peterweissig/eagle_dmx_opa/images/front_view.jpg

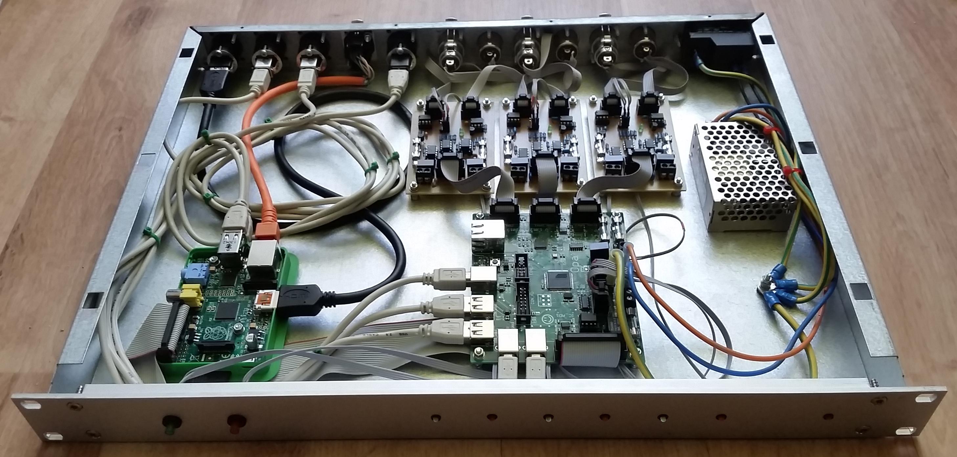
images/front_view.jpg
