peterweissig/eagle_dmx_opa/images/top_view.jpg

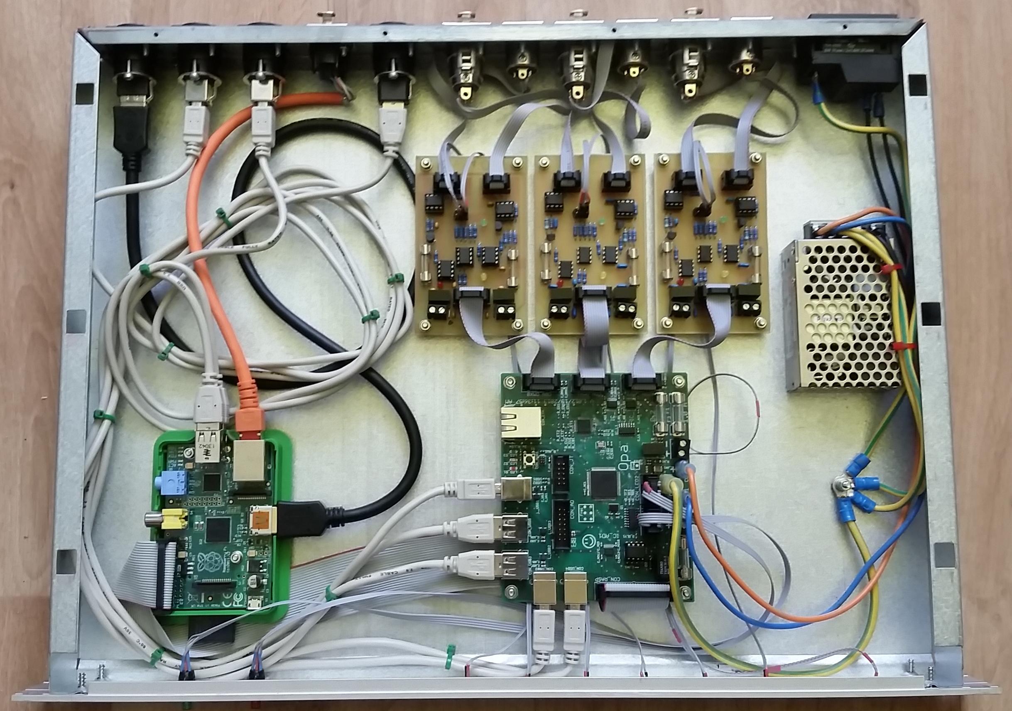
images/top_view.jpg
