peterweissig/eagle_dmx_opa/README.md

# project_opa
DMX control unit, based on atmel 32-bit controller
