peterweissig/eagle_dmx_opa/circuit/export/images/circuit_p1_controller.png

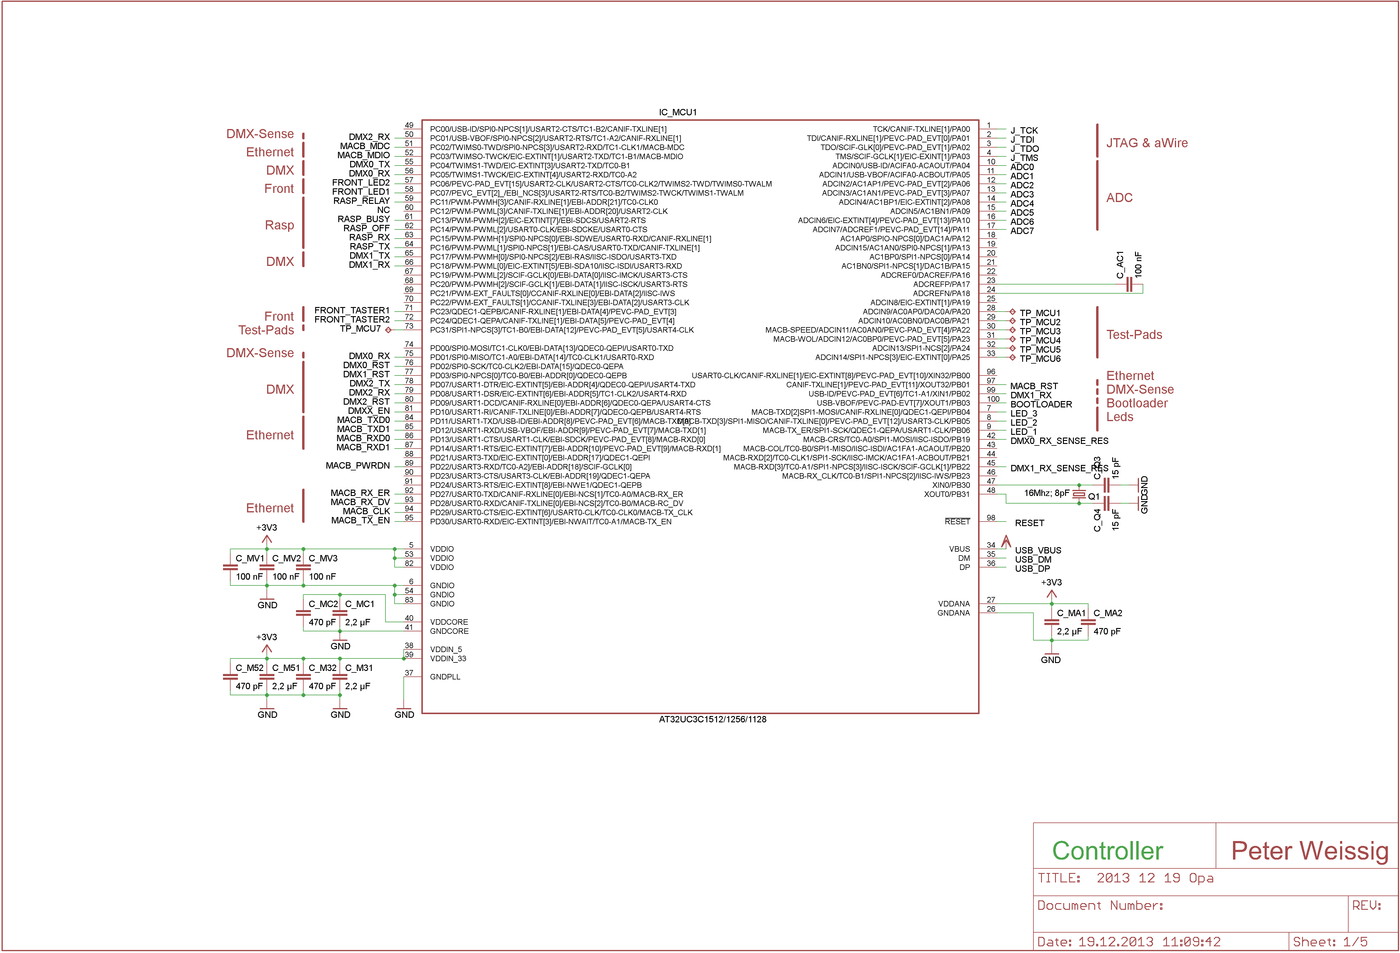
circuit/export/images/circuit_p1_controller.png
