peterweissig/eagle_dmx_opa/circuit/export/images/circuit_p2_ethernet.png

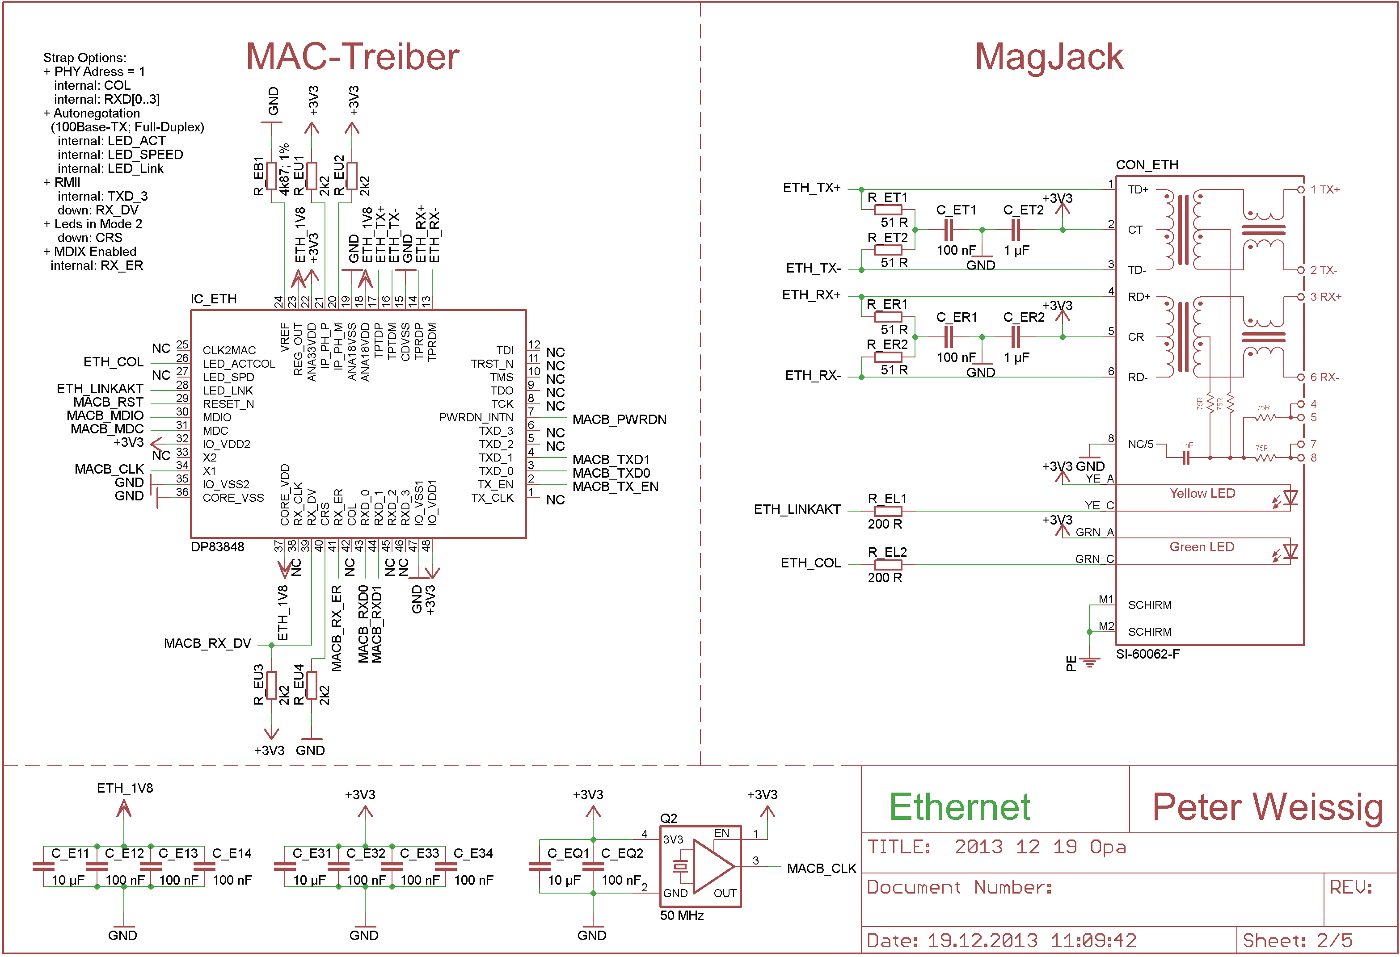
circuit/export/images/circuit_p2_ethernet.png
