peterweissig/eagle_dmx_opa/circuit/export/images/circuit_p3_schnittstellen.png

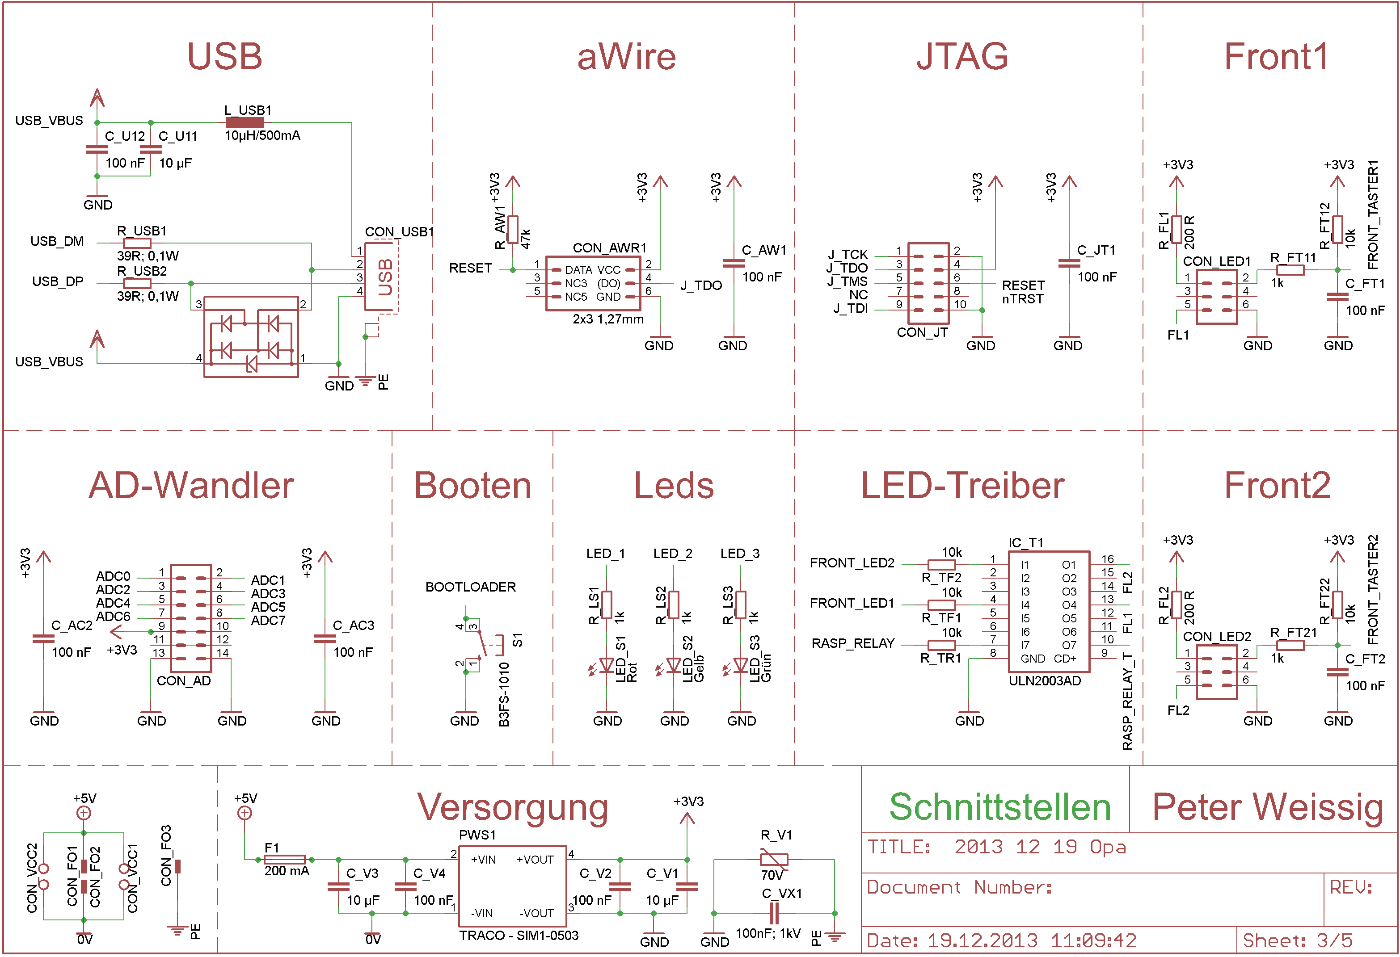
circuit/export/images/circuit_p3_schnittstellen.png
