peterweissig/eagle_dmx_opa/circuit/export/images/circuit_p4_dmx.png

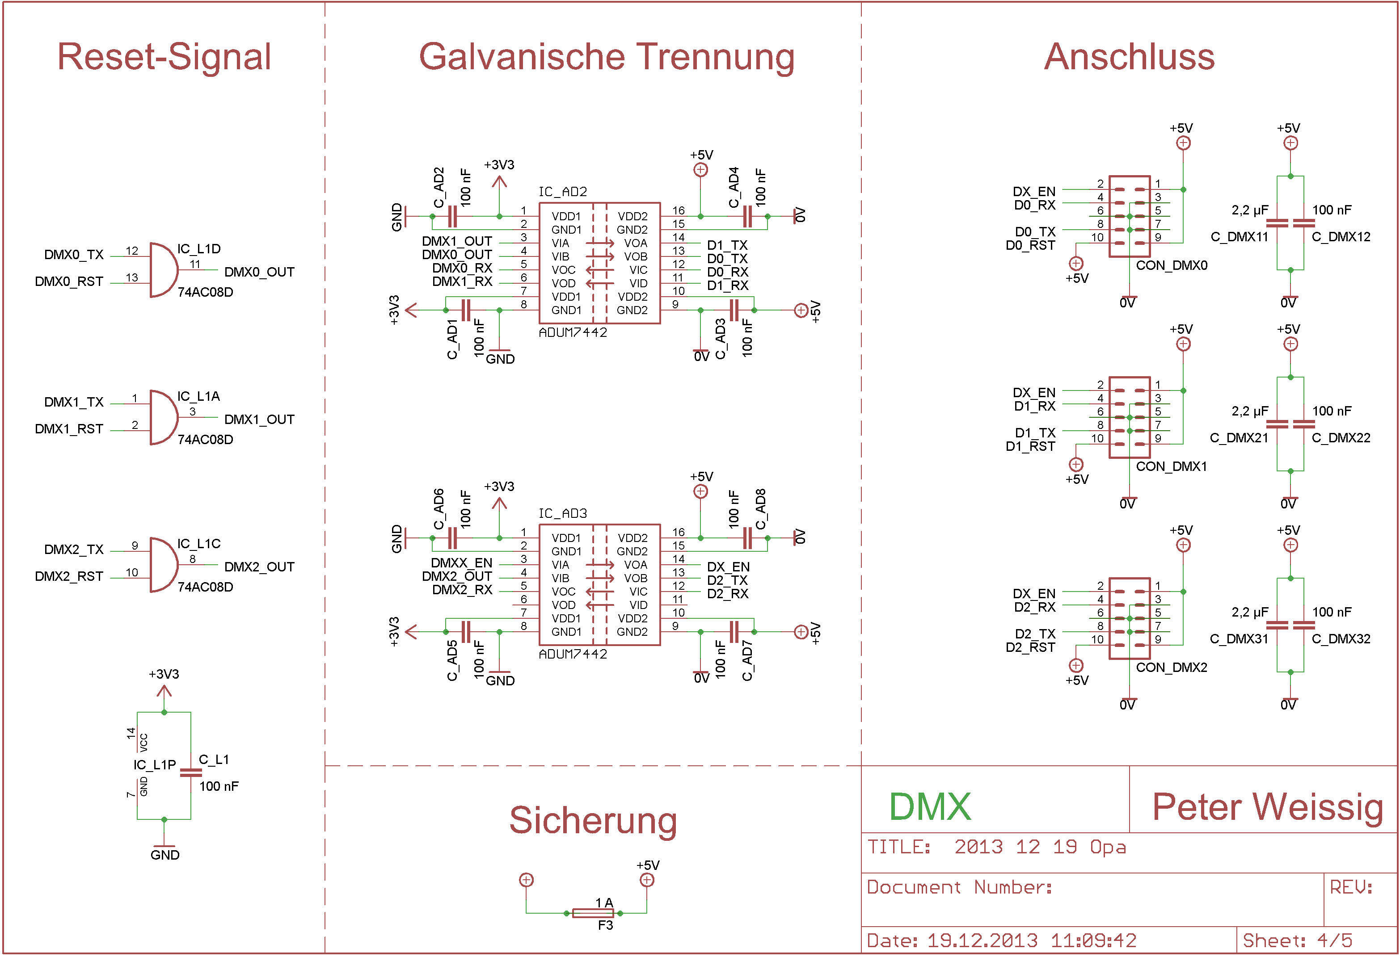
circuit/export/images/circuit_p4_dmx.png
