peterweissig/eagle_dmx_opa/circuit/export/images/circuit_p5_raspberry.png

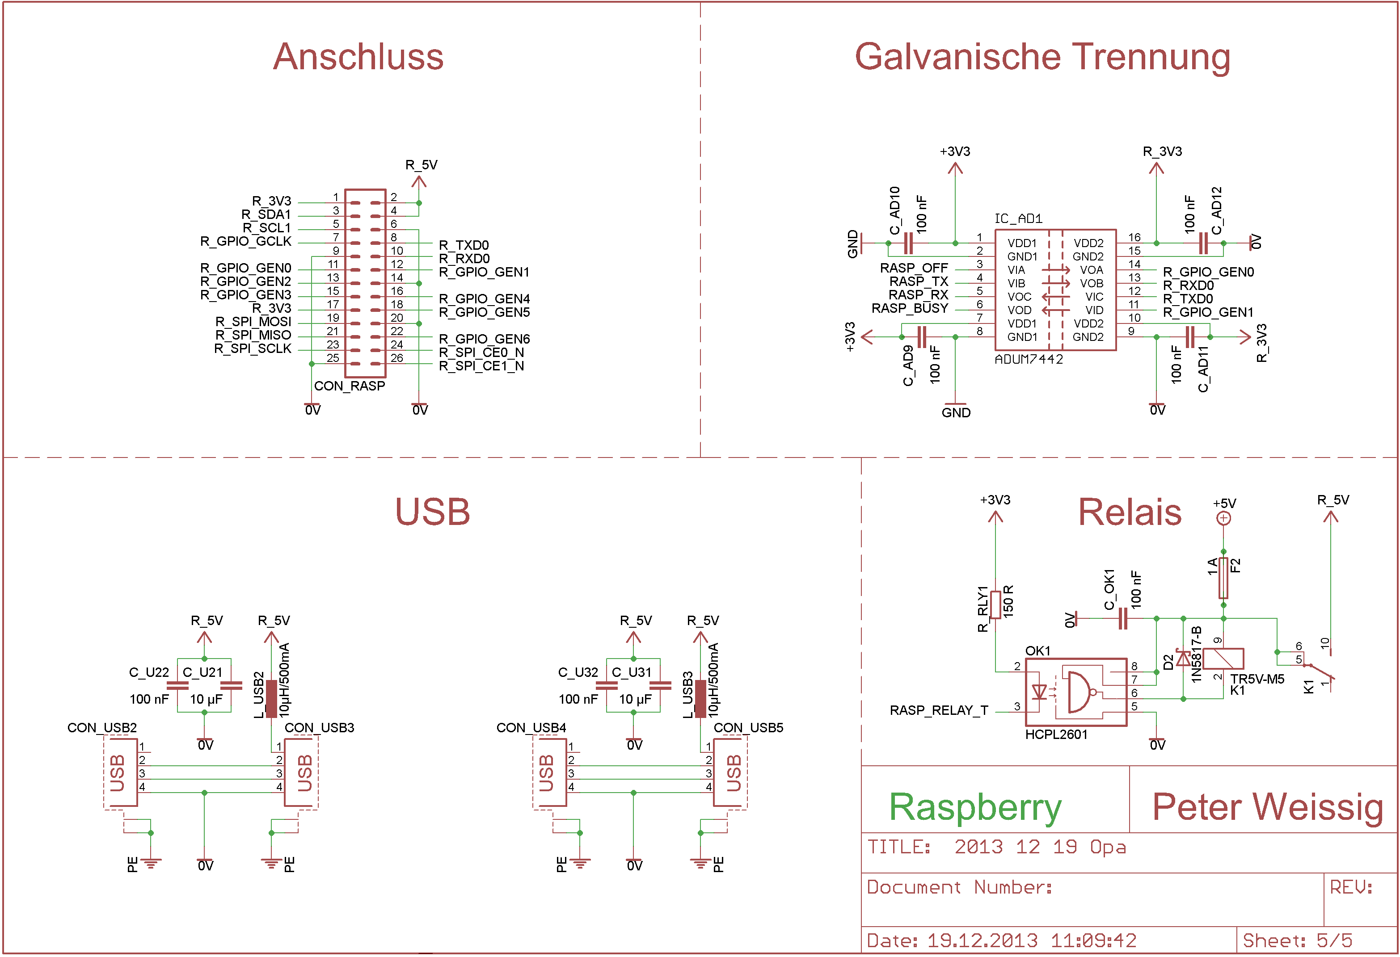
circuit/export/images/circuit_p5_raspberry.png
