peterweissig/eagle_dmx_opa/circuit/export/images/layout_bottom.png

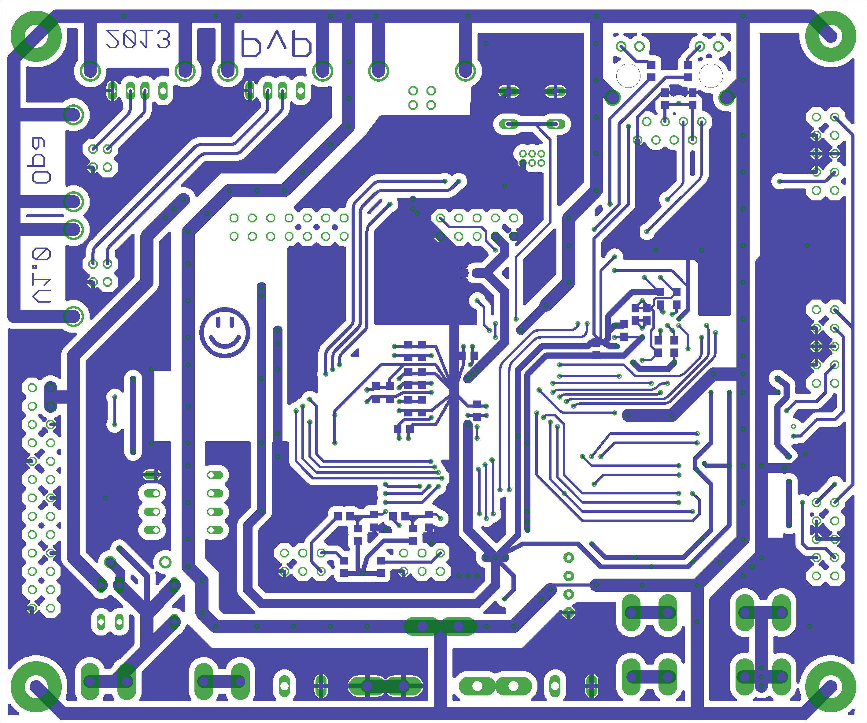
circuit/export/images/layout_bottom.png
