peterweissig/eagle_dmx_opa/circuit/export/images/layout_top.png

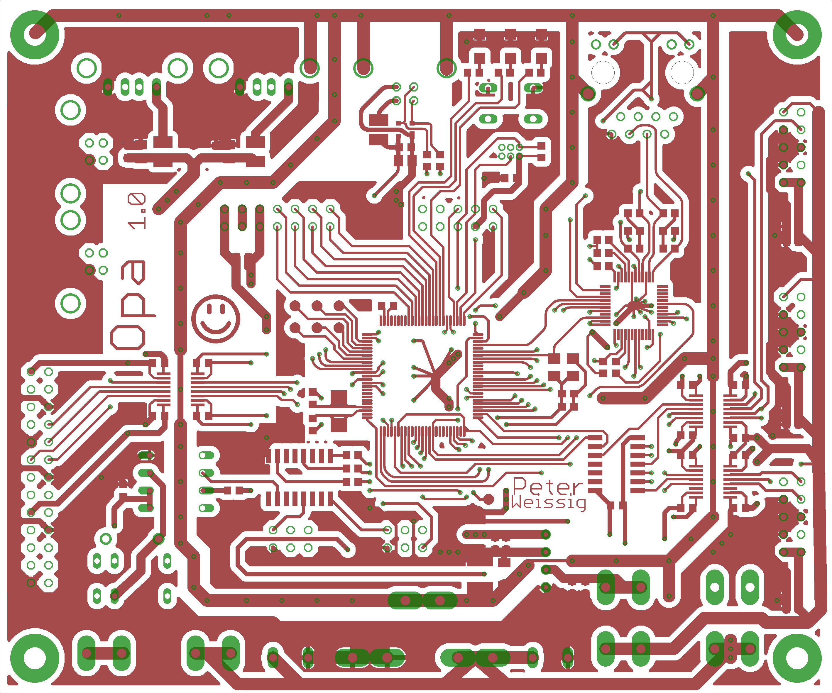
circuit/export/images/layout_top.png
