peterweissig/eagle_dmx_opa/drawings/images/front.png

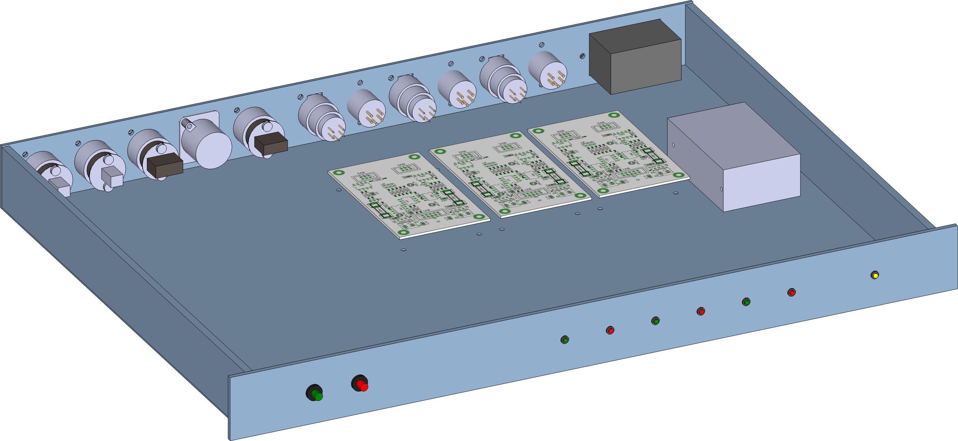
drawings/images/front.png
