peterweissig/eagle_dmx_opa/drawings/images/rear.png

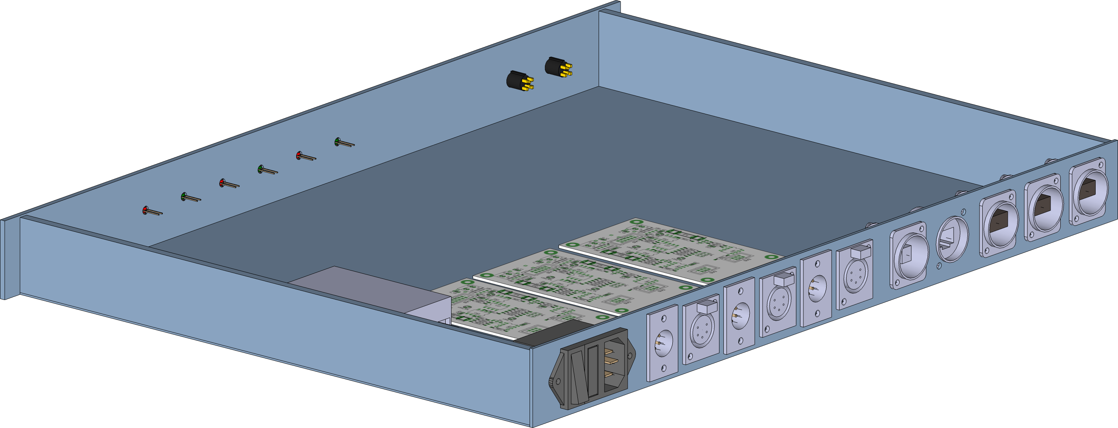
drawings/images/rear.png
