peterweissig/eagle_dmx_opa/drawings/images/top.png

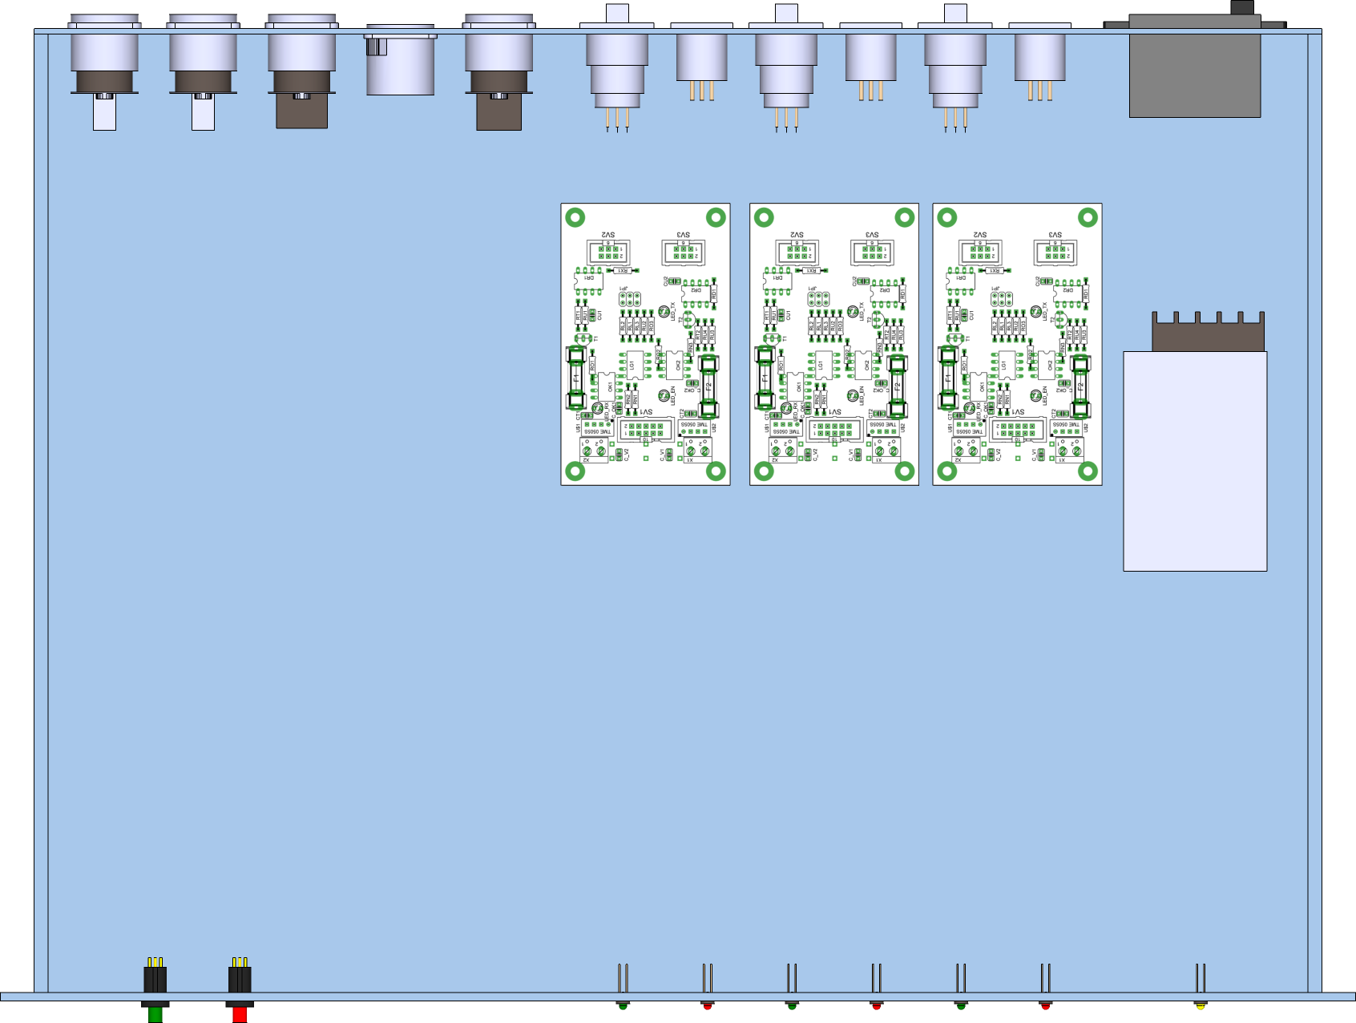
drawings/images/top.png
