peterweissig/eagle_dmx_opa/circuit/parts/parts.pdf

Bauteile Opa | 19.12.2013
Gruppe | Beschreibung | Bauteile | Anzahl | Händler | BestellNr. | Preis | Summe
| SMD SO16; NPN Transistoren im IC-Gehäuse | IC_T1 | 1 | Reichelt | ULN 2003 AD SMD (http://www.reichelt.de/index.html?ACTION=3;ARTICLE=18887;SEARCH=ULN%202003%20AD%20SMD) | 0,29 € | 0,29 €
| SMD SO14; Logik-Gatter - 4x Und; 74HC08 | IC_L1 | 1 | Reichelt | 74AC 08D-SMD (http://www.reichelt.de/index.html?ACTION=3;ARTICLE=58134;SEARCH=74AC%2008D-SMD) | 0,28 € | 0,28 €
| ADUM7442 | IC_ADx (3x) | 3 | Farnell | 1827344 (http://de.farnell.com/analog-devices/adum7442arqz/isolator-digital-quad-16qsop/dp/1827344) | 4,27 € | 12,81 €
| DP83848i | IC_ETH | 1 | Farnell | 1286816 (http://de.farnell.com/texas-instruments/dp83848cvv/10-100-ethernet-phy-smd-lqfp48/dp/1286816) | 4,11 € | 4,11 €
| AT32UC3C1512 | IC_MCU1 | 1 | Farnell | 1972032 (http://de.farnell.com/atmel/at32uc3c1512c-aut/mcu-32bit-512k-flash-100tqfp/dp/1972032?Ntt=AT32UC3C1512) | 19,67 € | 19,67 €
| SMD 0603; 10 µF; 6,3V; X5R | C_E11, C_E31, C_EQ1, C_Ux1 (3x), C_V1, C_V3 | 6 | Reichelt | X5R-G0603 10/6 (http://www.reichelt.de/Vielschicht-SMD-G0603-High-Cap/X5R-G0603-10-6/3/index.html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) | 0,07 € | 0,42 €
| SMD 0603; 2,2µF; 16V; X5R | C_Mx1 (4x), C_DMXx1 (3x) | 7 | Reichelt | X5R-G0603 2,2/16 (http://www.reichelt.de/Vielschicht-SMD-G0603-High-Cap/X5R-G0603-2-2-16/3/index.html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) | 0,05 € | 0,35 €
| SMD 0603; 1 µF; 25V; X5R | C_ER2 C_ET2 | 2 | Reichelt | X5R-G0603 1,0/25 (http://www.reichelt.de/Vielschicht-SMD-G0603-High-Cap/X5R-G0603-1-0-25/3/index.html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) | 0,05 € | 0,10 €
| SMD 1812; 100 nF; 1kV; X5R | C_VX1 | 1 | Farnell | 2085218 (http://de.farnell.com/kemet/c1812v104kdractu/kondensator-100nf-1000v-x7r-1812/dp/2085218) | 0,60 € | 0,60 €

Kondensatoren

## Teil 1 ICs

Peter Weissig | V 1.0.0 | Seite 1 von 4

Gruppe | Beschreibung | Bauteile | Anzahl | Händler | BestellNr. | Preis | Summe
| SMD 0603; 100 nF; 16V; X7R | C_ADx (12x), C_ACx (3x), C_DMXx2 (3x), X_Ex2 (3x), C_MVx (3x), C_Ux2 (3x), C_ER1, C_ET1, C_Ex3 (2x), C_Ex4 (2x), C_FTx (2x), C_V2, C_V4, C_AW1, C_JT1, C_L1, C_OK1
41 | Reichelt | X7R-G0603 100N (http://www.reichelt.de/Vielschicht-SMD-G0603/X7R-G0603-100N/3/index.html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) | 0,05 € | 2,05 €
SMD 0603; 470 pF; 50V; X7R | C_Mx2 (4x) | 4 | Reichelt | X7R-G0603 470P (http://www.reichelt.de/Vielschicht-SMD-G0603/X7R-G0603-470P/3/index.html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) | 0,05 € | 0,20 €
SMD 0603; 10 pF (15 pF); 50V; GP0 | C_Q3 C_Q4 | 2 | Reichelt | NPO-G0603 10P (http://www.reichelt.de/Vielschicht-SMD-G0603/NPO-G0603-10P/3/index.html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) | 0,05 € | 0,10 €
Varistor | SMD 1206; 30V (70V) | R_V1 | 1 | Reichelt | VC 1206-30 (http://www.reichelt.de/Heissleiter-Varistoren/VC-1206-30/3/index.html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) | 0,24 € | 0,24 € Kondensatoren Teil 2

Gruppe | Beschreibung | Bauteile | Anzahl | Händler | BestellNr. | Preis | Summe
| SMD 0603; 47k; 1% | R_AW1 | 1 | Reichelt | SMD-0603 47K (http://www.reichelt.de/SMD-0603-10-0-k-Ohm-82-0-k-Ohm/SMD-0603-47K/3/index.html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) | 0,10 € | 0,10 €
| SMD 0603; 10k; 1% | R_FTx2 (2x), R_TFx (2x), R_TR1 | 5 | Reichelt | SMD-0603 10K (http://www.reichelt.de/SMD-0603-10-0-k-Ohm-82-0-k-Ohm/SMD-0603-10K/3/index.html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) | 0,10 € | 0,50 €
| SMD 0603; 4k7 (4k87); 1% | R_EB1 | 1 | Reichelt | SMD-0603 4,7K (http://www.reichelt.de/SMD-0603-1-00-k-Ohm-8-20-k-Ohm/SMD-0603-4-7K/3/index.html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) | 0,10 € | 0,10 €
| SMD 0603; 2k2; 1% | R_Eux (4x) | 4 | Reichelt | SMD-0603 2,2K (http://www.reichelt.de/SMD-0603-1-00-k-Ohm-8-20-k-Ohm/SMD-0603-2-2K/3/index.html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) | 0,10 € | 0,40 €
| SMD 0603; 1k; 1% | R_LSx (3x), R_FTx1 (2x) | 5 | Reichelt | SMD-0603 1,0K (http://www.reichelt.de/SMD-0603-1-00-k-Ohm-8-20-k-Ohm/SMD-0603-1-0K/3/index.html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) | 0,10 € | 0,50 €
| SMD 0603; 220 R (200 R); 1% | R_ELx (2x) R_FLx (2x) | 4 | Reichelt | SMD-0603 220 (http://www.reichelt.de/SMD-0603-100-Ohm-820-Ohm/SMD-0603-220/3/index.html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) | 0,10 € | 0,40 €
| SMD 0603; 150 R; 1% | R_RLY1 | 1 | Reichelt | SMD-0603 150 (http://www.reichelt.de/SMD-0603-100-Ohm-820-Ohm/SMD-0603-150/3/index.html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) | 0,10 € | 0,10 €
| SMD 0603; 47 R (51 R); 1% | R_ERx (2x) R_ETx (2x) | 4 | Reichelt | SMD-0603 47 (http://www.reichelt.de/SMD-0603-1-00-Ohm-82-0-Ohm/SMD-0603-47/3/index.html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) | 0,10 € | 0,40 €
| SMD 0603; 39 R; 1% | R_USBx (2x) | 2 | Reichelt | SMD-0603 39 (http://www.reichelt.de/SMD-0603-1-00-Ohm-82-0-Ohm/SMD-0603-39/3/index.html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) | 0,10 € | 0,20 €
| SMD 1206; Grün; 2,2V; 25mA | LED_S3 | 1 | Reichelt | SMD-LED 1206 GN (http://www.reichelt.de/SMD-LED-0603-0805-1206/SMD-LED-1206-GN/3/index.html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) | 0,10 € | 0,10 €
| SMD 1206; Gelb; 2,1V; 30mA | LED_S2 | 1 | Reichelt | SMD-LED 1206 GE (http://www.reichelt.de/SMD-LED-0603-0805-1206/SMD-LED-1206-GE/3/index.html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) | 0,11 € | 0,11 €
| SMD 1206; Rot; 2,0V; 30mA | LED_S1 | 1 | Reichelt | SMD-LED 1206 RT (http://www.reichelt.de/SMD-LED-0603-0805-1206/SMD-LED-1206-RT/3/index.html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) | 0,13 € | 0,13 €
Quarz | 50 Mhz; xyz | Q2 | 1 | ? | | | 0,00 €
| SMD ; 16MHz; +/- 200ppm; 8pF | Q1 | 1 | ? | NX5032GA | | 0,00 €
Dioden | SMD SOT-143B; ESD-Schutz; 5,5V; PRTR5V0U2X | D1 | 1 | Farnell | 1524157 (http://de.farnell.com/nxp/prtr5v0u2x/diode-tvs-dual-sot-143b/dp/1524157) | 0,33 € | 0,33 €
| DO41; 1A; 30V; 1N5818 | D2 | 1 | Reichelt | 1N 5818 (http://www.reichelt.de/1N-UF-AA-Dioden/1N-5818/3/index.html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) | 0,06 € | 0,06 €
Spule | SMD 1210; 10µH; 300mA (500mA); 26MHz; 0,44 R | L_USBx (3x) | 3 | Reichelt | LQH3C 10µ (http://www.reichelt.de/Fest-Induktivitaeten-SMD/LQH3C-10-/3/index.html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) | 0,12 € | 0,36 €
Koppler | Relais; 60V; 2A; 1x; TR5V-M5 | K1 | 1 | Reichelt | TR5V-M 5V (http://www.reichelt.de/Miniaturrelais/TR5V-M-5V/3/index.html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) | 0,80 € | 0,80 €
| DIP8; Optokoppler; 1x; HCPL2601; siehe auch IC-SockelOK1 | | 1 | Reichelt | HCPL 2601 (http://www.reichelt.de/Optokoppler/HCPL-2601/3/index.html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) | 1,10 € | 1,10 €
Spg-Regler | SIL4; 5V auf 3,3V; 1W; Galv. Getrennt | PWS1 | 1 | Reichelt | SIM1-0503 SIL4 (http://www.reichelt.de/Wandler-Module-DC-DC/SIM1-0503-SIL4/3/index.html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) | 4,65 € | 4,65 €
Schalter | Kurzhubtaster; 6x6mm; h 5mm; 12V; 50mA | S1 | 1 | Reichelt | TASTER 9302 (http://www.reichelt.de/Kurzhubtaster/TASTER-9302/3/index.html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) | 0,11 € | 0,11 €
Sicher- | 5x20mm; 1,0 A; siehe auch Halterungen | F2 F3 | 2 | Reichelt | FLINK 1,0A (http://www.reichelt.de/5x20mm-Feinsicherungen/FLINK-1-0A/3/index.html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) | 0,32 € | 0,64 €
| 5x20mm; 200 mA; siehe auch Halterungen | F1 | 1 | Reichelt | FLINK 0,2A (http://www.reichelt.de/5x20mm-Feinsicherungen/FLINK-0-2A/3/index.html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) | 0,32 € | 0,32 €

# ungenWiderstände Leds

Gruppe | Beschreibung | Bauteile | Anzahl | Händler | BestellNr. | Preis | Summe
| 5mm; b 6,35mm; siehe auch Flachsteckerhülsen | CON_FOx (3x) | 3 | Reichelt | FS-P 6,35 (http://www.reichelt.de/Flachstecker/FS-P-6-35/3/index.html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) | 0,05 € | 0,15 €
| 5,08mm; 13A; 2x; d 0,9mm | CON_VCCx | 2 | Reichelt | AKL 101-02 (http://www.reichelt.de/Kurzhubtaster/TASTER-9302/3/index.html?ACTION=3;ARTICLE=36605;SEARCH=AKL%20101-02) | 0,31 € | 0,62 €
| 2x3 1,27mm | CON_AWR1 | 1 | Reichelt | SL 2X10G 1,27 (http://www.reichelt.de/Stiftleisten/SL-2X10G-1-27/3/index.html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) | 0,24 € | 0,24 €
| 2x3; 2,54mm; gerade; Wannstecker; siehe Pfostenbuchse CON_LEDx (2x) | | 2 | Reichelt | WSL 6G (http://www.reichelt.de/Stiftleisten/2/index.html?ACTION=3;ARTICLE=85732;SEARCH=WSL%206G) | 0,17 € | 0,34 €
| 2x5; 2,54mm; gerade; Wannstecker; siehe Pfostenbuchse CON_DMXx (3x) | CON_JT | 4 | Reichelt | WSL 10G (http://www.reichelt.de/Stiftleisten/2/index.html?ACTION=3;ARTICLE=22816;SEARCH=WSL%2010G) | 0,08 € | 0,32 €
| 2x7; 2,54mm; gerade; Wannstecker; siehe Pfostenbuchse CON_AD | | 1 | Reichelt | WSL 14G (http://www.reichelt.de/Stiftleisten/2/index.html?ACTION=3;ARTICLE=22819;SEARCH=WSL%2014G) | 0,11 € | 0,11 €
| 2x13; 2,54mm; gerade; Wannstecker; siehe Pfostenbuchse CON_RASP | | 1 | Reichelt | WSL 26G (http://www.reichelt.de/Stiftleisten/2/index.html?ACTION=3;ARTICLE=22828;SEARCH=WSL%2026G) | 0,15 € | 0,15 €
| USB A; Buchse; gewinkelt | CON_USB3 CON_USB5 | 2 | Reichelt | USB AW (http://www.reichelt.de/USB-FireWire-Verbinder/USB-AW/3/index.html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) | 0,22 € | 0,44 €
| USB B; Buchse; gewinkelt | CON_USB1 CON_USB2 CON_USB4 | 3 | Reichelt | USB BW (http://www.reichelt.de/USB-FireWire-Verbinder/USB-BW/3/index.html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) | 0,22 € | 0,66 €
| MagJack; 2x Led; Galv. getrennt | CON_ETH | 1 | Farnell | 1137983 (http://de.farnell.com/stewart-connector/si-60062-f/kupplung-10-100base-ethernet-led/dp/1137983?Ntt=1137983) | 4,72 € | 4,72 €
| 5x20mm; Halterungen für Sicherungen | Fx | 6 | Reichelt | PL 120000 (http://www.reichelt.de/Sicherungshalter/PL-120000/3/index.html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) | 0,07 € | 0,42 €
| DIP8; IC-Sockel | OK1 | 1 | Reichelt | GS 8 (http://www.reichelt.de/IC-Sockel/GS-8/3/index.html?ACTION=3&LA=2&ARTICLE=8230&GROUPID=3215&artnr=GS+8) | 0,04 € | 0,04 €
| 6,35mm; Blau; 0,5-1,5mm²; 15A; Isoliert; Flachsteckerhülse CON_FO1 | | 1 | Reichelt | IFSH-B-6,35 (http://www.reichelt.de/Flachstecker/IFSH-B-6-35/3/index.html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) | 0,09 € | 0,09 €
| 6,35mm; Rot; 0,5-1,5mm²; 15A; Isoliert; Flachsteckerhülse CON_FO2 | | 1 | Reichelt | IFSH-R-6,35 (http://www.reichelt.de/Flachstecker/FSH-G-6-35/3/index.html?ACTION=3;ARTICLE=8770;SEARCH=IFSH-R-6,35,) | 0,08 € | 0,08 €
| 6,35mm; Gelb; 0,5-1,5mm²; 15A; Isoliert; Flachsteckerhülse CON_FO3 | | 1 | Reichelt | IFSH-G-6,35 (http://www.reichelt.de/Flachstecker/IFSH-G-6-35/3/index.html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) | 0,11 € | 0,11 €
| 6,35mm; Blau; 0,5-1,5mm²; Alternative; Flachsteckerhülse CON_FO1 | | 1 | Reichelt | FSH-B-6,35 (http://www.reichelt.de/Flachstecker/FSH-B-6-35/3/index.html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) | 0,06 € | 0,06 €
| 6,35mm; Rot; 0,5-1,5mm²; Alternative; Flachsteckerhülse CON_FO2 | | 1 | Reichelt | FSH-R-6,35 (http://www.reichelt.de/Flachstecker/FSH-R-6-35/3/index.html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) | 0,06 € | 0,06 €
| 6,35mm; Gelb; 0,5-1,5mm²; Alternative; Flachsteckerhülse CON_FO3 | | 1 | Reichelt | FSH-G-6,35 (http://www.reichelt.de/Flachstecker/FSH-R-6-35/3/index.html?ACTION=3;ARTICLE=7910;SEARCH=FSH-G-6,35) | 0,07 € | 0,07 €
| 2x3; 2,54mm; gerade; Pfostenbuchse | CON_LEDx (2x) | 2 | Reichelt | PFL 6 (http://www.reichelt.de/Pfosten-Wannenstecker/2/index.html?ACTION=3;ARTICLE=53153;SEARCH=PFL%206) | 0,24 € | 0,48 €
| 2x5; 2,54mm; gerade; Pfostenbuchse | CON_DMXx (3x) | 6 | Reichelt | PFL 10 (http://www.reichelt.de/Pfosten-Wannenstecker/PFL-10/3/index.html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) | 0,08 € | 0,48 €
| 2x7; 2,54mm; gerade; Pfostenbuchse | CON_AD | 2 | Reichelt | PFL 14 (http://www.reichelt.de/Pfosten-Wannenstecker/PFL-14/3/index.html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) | 0,12 € | 0,24 €
| 2x13; 2,54mm; gerade; Pfostenbuchse | CON_RASP | 2 | Reichelt | PFL 26 (http://www.reichelt.de/Pfosten-Wannenstecker/PFL-26/3/index.html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) | 0,17 € | 0,34 €

### Summe

Zusatz

62,85 €

Stecker
