peterweissig/eagle_dmx_opa/circuit/export/images/parts_bottom.png

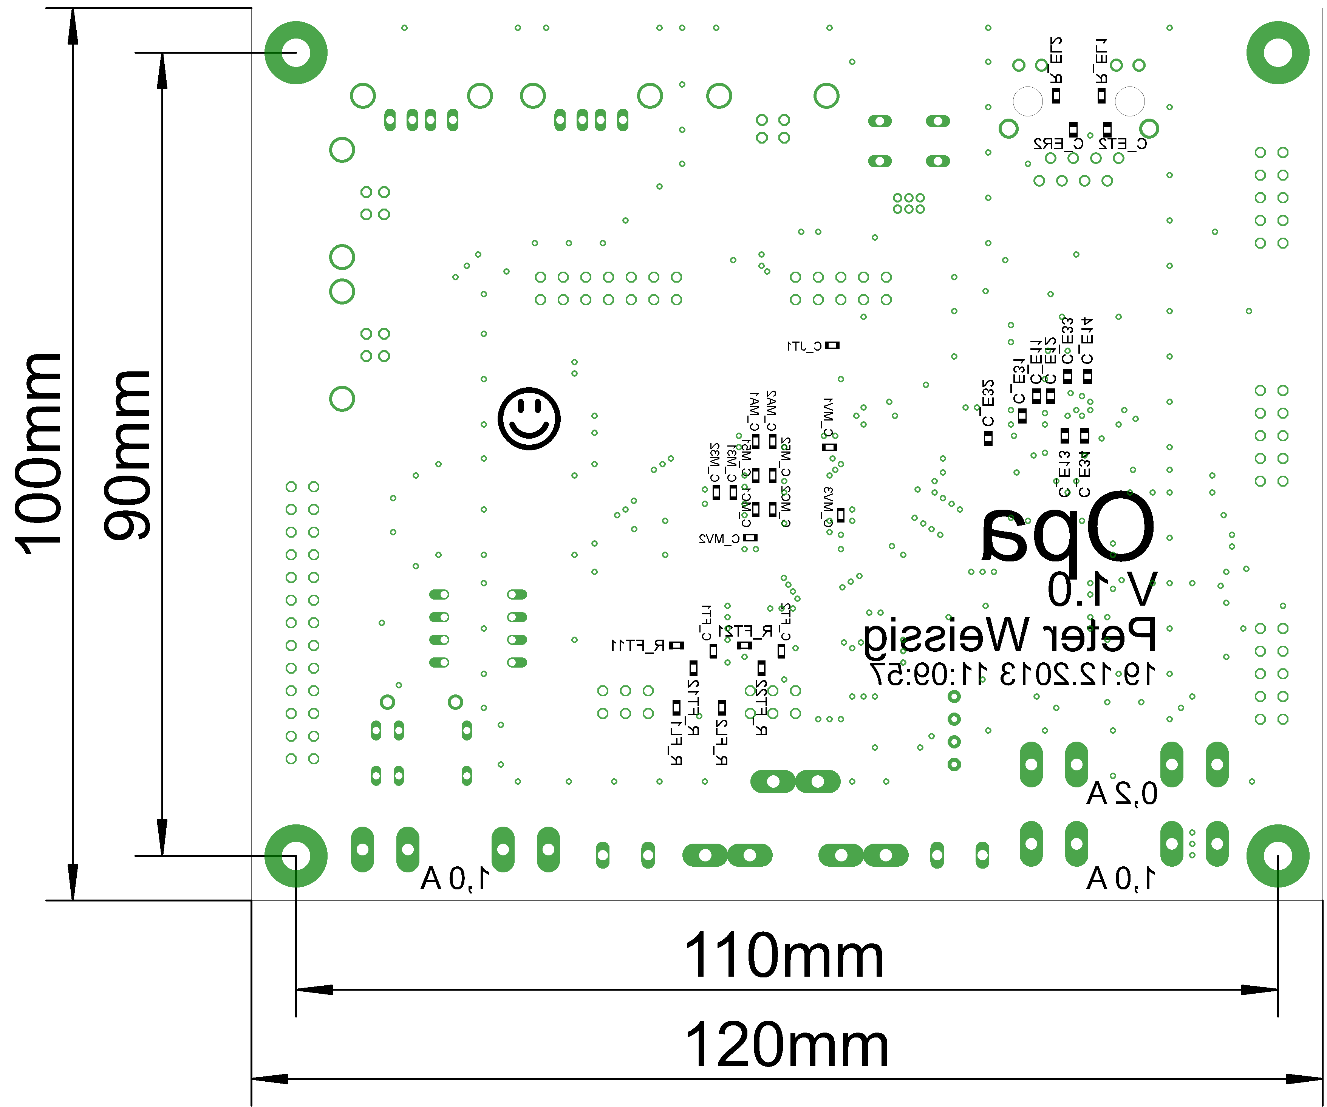
circuit/export/images/parts_bottom.png
