peterweissig/eagle_dmx_opa/circuit/export/images/parts_top.png

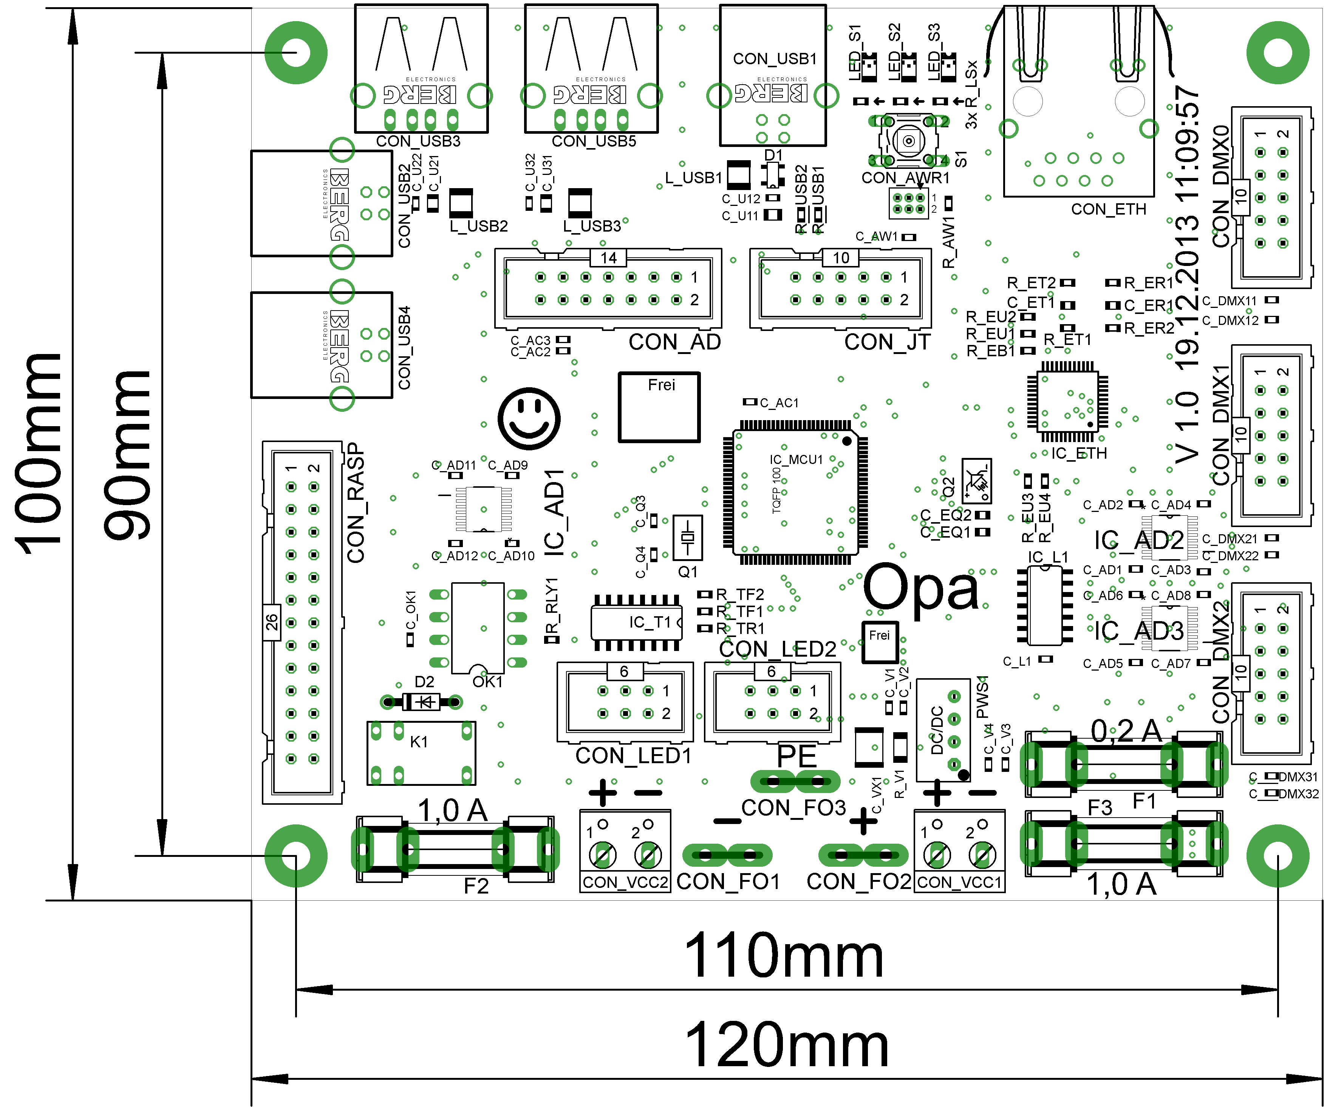
circuit/export/images/parts_top.png
