peterweissig/eagle_dmx_opa/(list of files, cad)

Other CAD files:
drawings/opa.skp
