peterweissig/eagle_dmx_opa/drawings/measures/measures_bottom.png

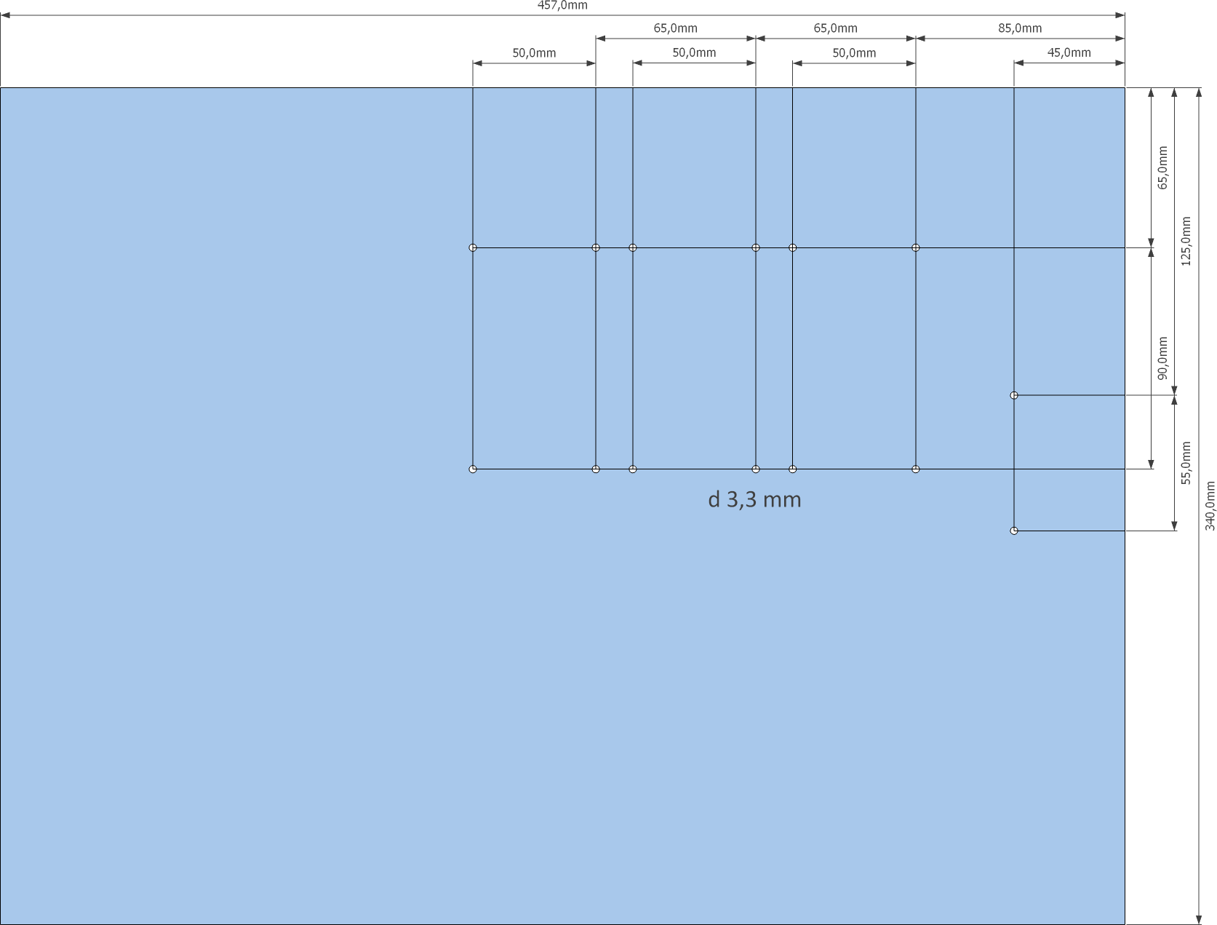
drawings/measures/measures_bottom.png
