peterweissig/eagle_dmx_opa/drawings/measures/measures_front.png

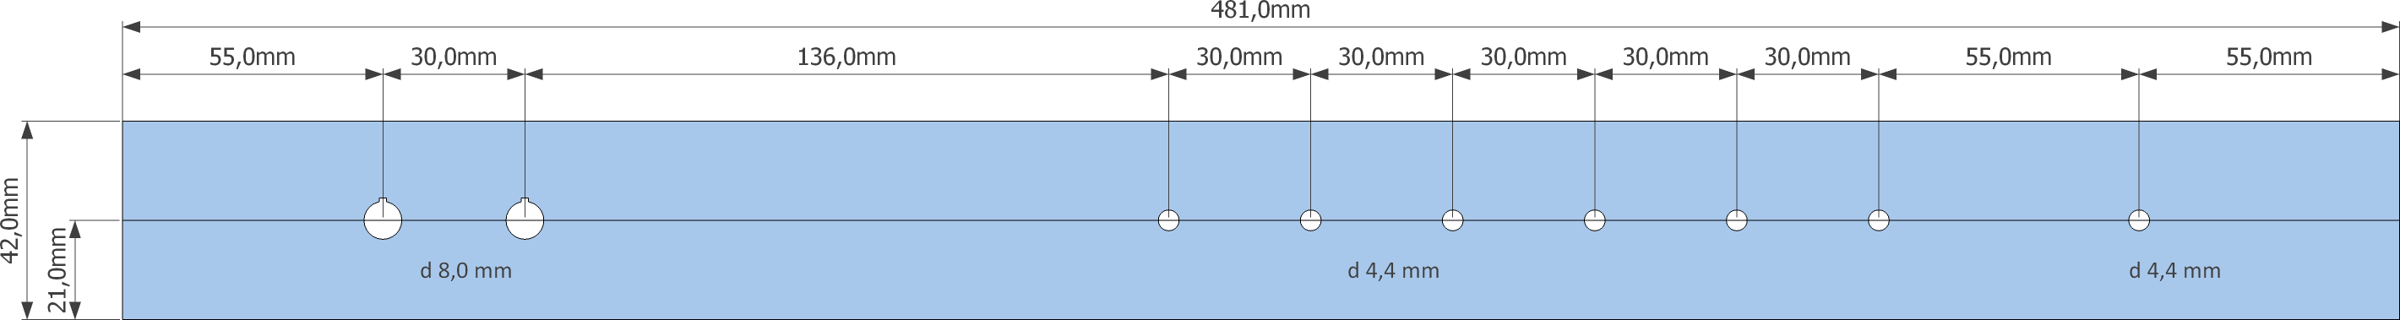
drawings/measures/measures_front.png
