peterweissig/eagle_dmx_opa/drawings/measures/measures_rear.png

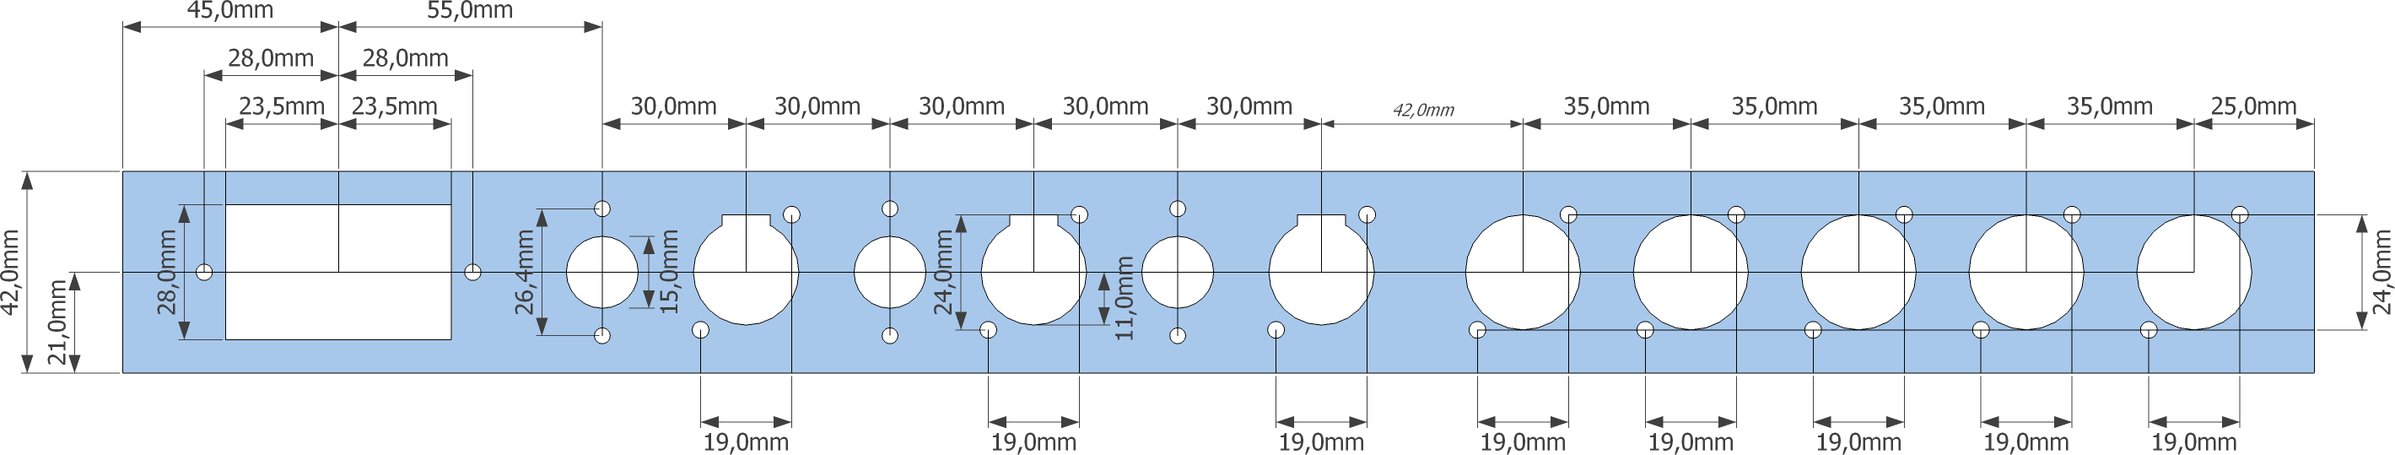
drawings/measures/measures_rear.png
