peterweissig/eagle_dmx_opa/drawings/measures/measures_rear_better.pdf

# Materialstärke 1mm; Biegung nach hinten; Innenmaß nach dem Biegen 38,1 mm

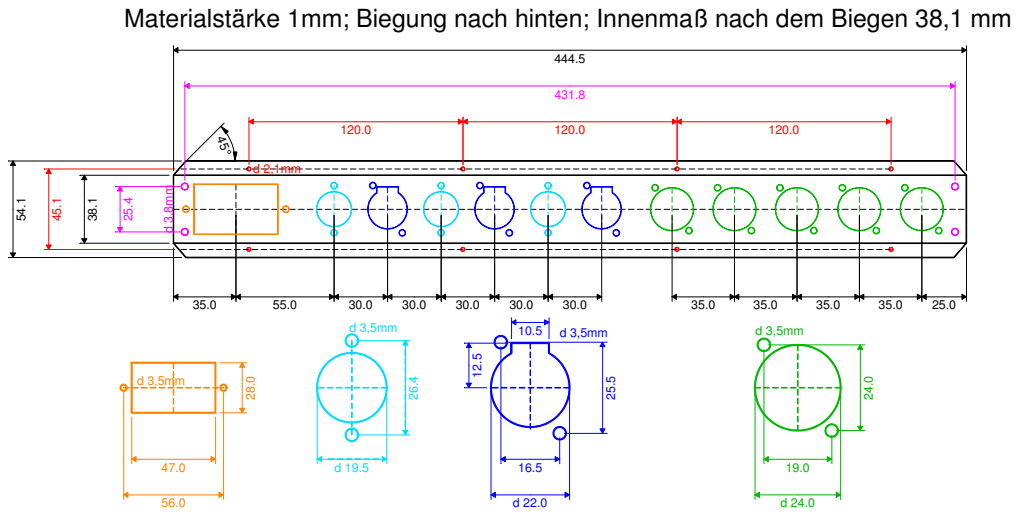
[picture p18: page 1]
