peterweissig/eagle_dmx_opa/circuit/export/images/circuit.pdf

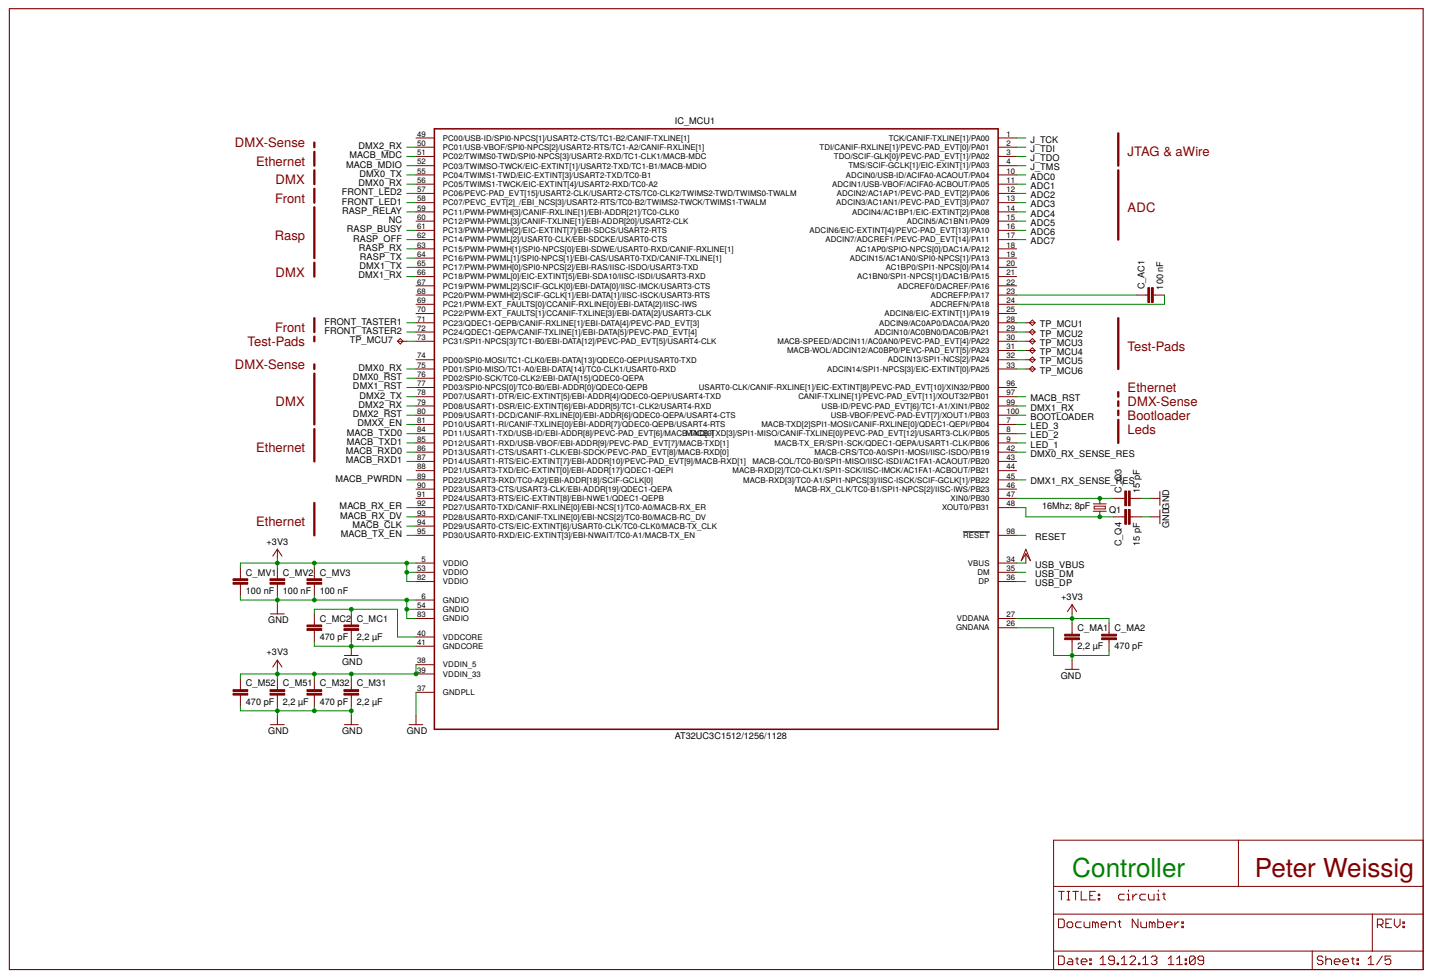
[picture p19: page 1]

1 TDI/CANIF-RXLINE[1]/PEVC-PAD_EVT[0]/PA01
2 TDO/SCIF-GLK[0]/PEVC-PAD_EVT[1]/PA02
3 TMS/SCIF-GCLK[1]/EIC-EXINT[1]/PA03
4 ADCIN0/USB-ID/ACIFA0-ACAOUT/PA04
10 ADCIN1/USB-VBOF/ACIFA0-ACBOUT/PA05
11 ADCIN2/AC1AP1/PEVC-PAD_EVT[2]/PA06
12 ADCIN3/AC1AN1/PEVC-PAD_EVT[3]/PA07
13 ADCIN4/AC1BP1/EIC-EXTINT[2]/PA08

USART0-CLK/CANIF-RXLINE[1]/EIC-EXTINT[8]/PEVC-PAD_EVT[10]/XIN32/PB00

96 CANIF-TXLINE[1]/PEVC-PAD_EVT[11]/XOUT32/PB01
99 USB-VBOF/PEVC-PAD-EVT[7]/XOUT1/PB03
USB-ID/PEVC-PAD_EVT[6]/TC1-A1/XIN1/PB02

100 MACB-TXD[2]SPI1-MOSI/CANIF-RXLINE[0]/QDEC1-QEPI/PB04
8 MACB-TX_ER/SPI1-SCK/QDEC1-QEPA/USART1-CLK/PB06

7 MACB-TXD[3]/SPI1-MISO/CANIF-TXLINE[0]/PEVC-PAD_EVT[12]/USART3-CLK/PB05

MACB-CRS/TC0-A0/SPI1-MOSI/IISC-ISDO/PB19

43 MACB-RXD[2]/TC0-CLK1/SPI1-SCK/IISC-IMCK/AC1FA1-ACBOUT/PB21
MACB-COL/TC0-B0/SPI1-MISO/IISC-ISDI/AC1FA1-ACAOUT/PB20
44 MACB-RXD[3]/TC0-A1/SPI1-NPCS[3]/IISC-ISCK/SCIF-GCLK[1]/PB22

MACB-RX_CLK/TC0-B1/SPI1-NPCS[2]/IISC-IWS/PB23
