peterweissig/eagle_dmx_opa/circuit/circuit.brd

## EAGLE design circuit/circuit.brd (2018-02-25)

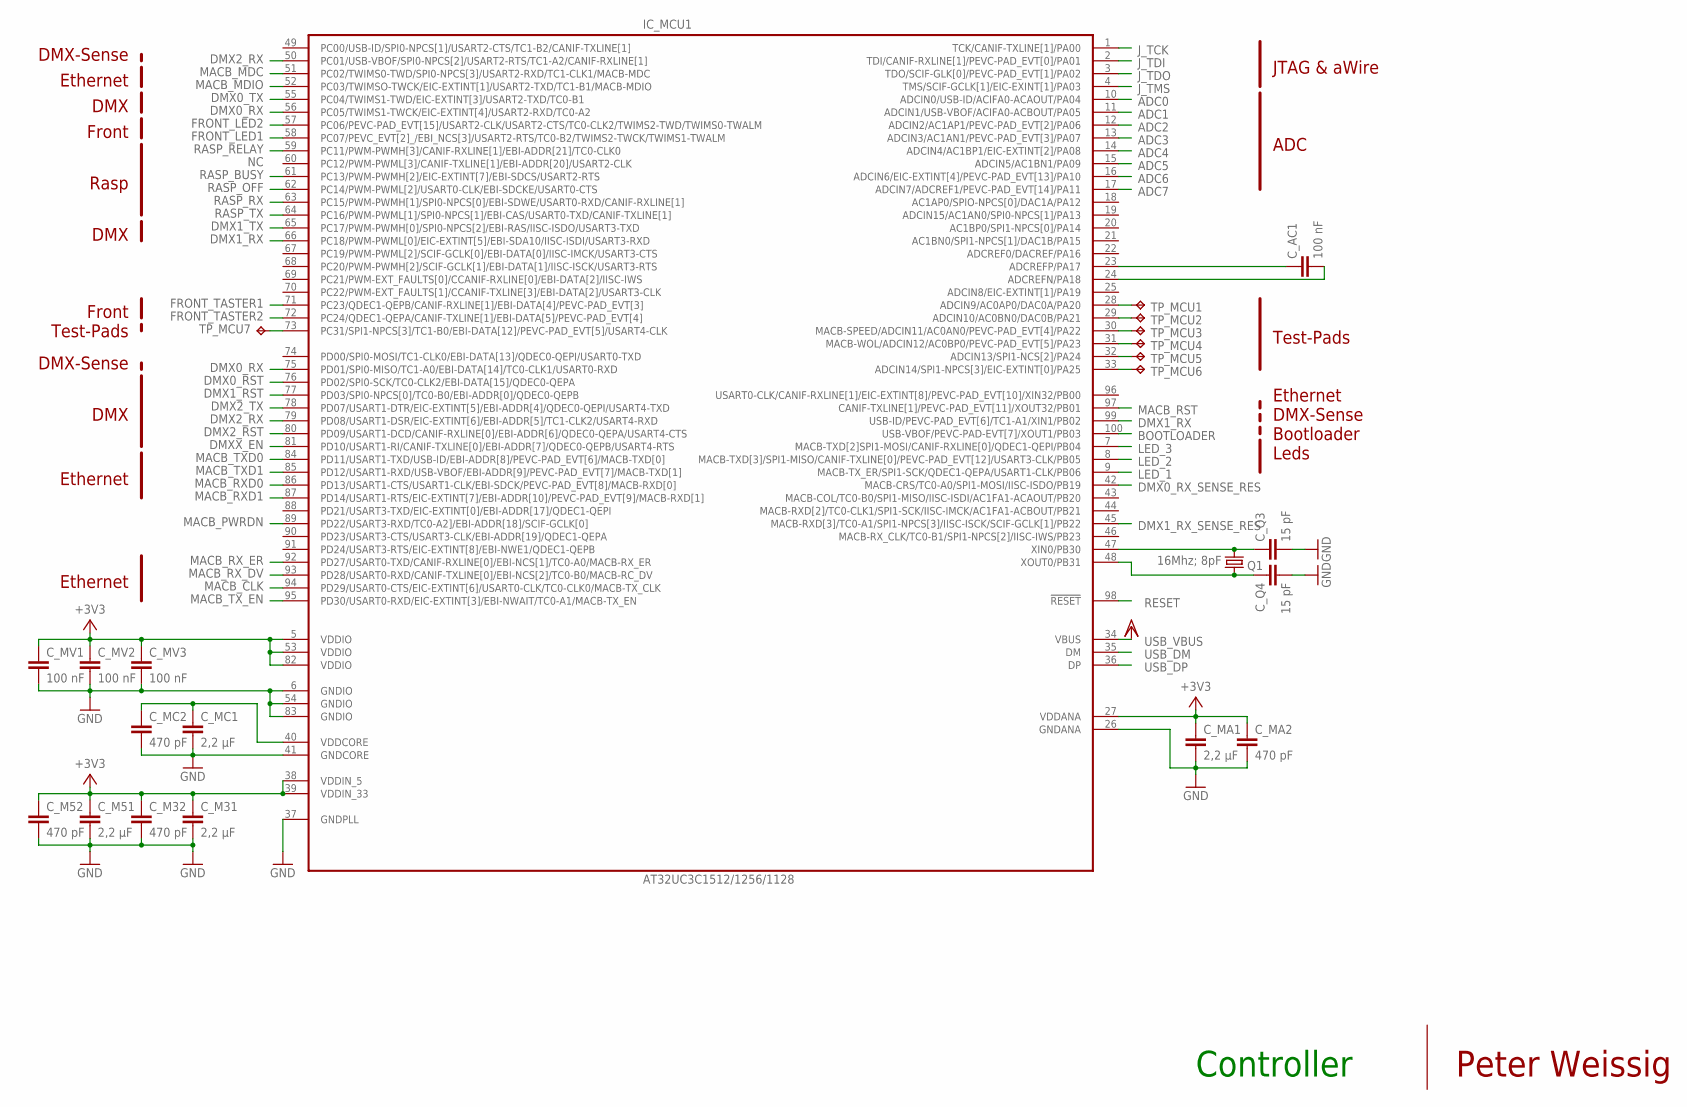
[picture p20: schematic circuit.sch, sheet 1, Controller]

Parts:
C_AC1: 100 nF; C0603K
C_M31, C_M51: 2,2 µF; C0603K
C_M32, C_M52: 470 pF; C0603K
C_MA1: 2,2 µF; C0603K
C_MA2: 470 pF; C0603K
C_MC1: 2,2 µF; C0603K
C_MC2: 470 pF; C0603K
C_MV1, C_MV2, C_MV3: 100 nF; C0603K
C_Q3, C_Q4: 15 pF; C0603K
IC_MCU1: AT32UC3C1512/1256/1128; TQFP100
Q1: 16Mhz; 8pF; NX5032
TP_MCU1, TP_MCU2, TP_MCU3, TP_MCU4, TP_MCU5, TP_MCU6, TP_MCU7: TPTP15R; TP15R

Connections:
+3V3: C_M31.1, C_M32.1, C_M51.1, C_M52.1, C_MA1.1, C_MA2.1, C_MV1.1, C_MV2.1, C_MV3.1, IC_MCU1.5 (VDDIO), IC_MCU1.27 (VDDANA), IC_MCU1.38 (VDDIN_5), IC_MCU1.39 (VDDIN_33), IC_MCU1.53 (VDDIO), IC_MCU1.82 (VDDIO); also elsewhere on the board
ADC0: IC_MCU1.10 (ADCIN0/USB-ID/ACIFA0-ACAOUT/PA04); also elsewhere on the board
ADC1: IC_MCU1.11 (ADCIN1/USB-VBOF/ACIFA0-ACBOUT/PA05); also elsewhere on the board
ADC2: IC_MCU1.12 (ADCIN2/AC1AP1/PEVC-PAD_EVT[2]/PA06); also elsewhere on the board
ADC3: IC_MCU1.13 (ADCIN3/AC1AN1/PEVC-PAD_EVT[3]/PA07); also elsewhere on the board
ADC4: IC_MCU1.14 (ADCIN4/AC1BP1/EIC-EXTINT[2]/PA08); also elsewhere on the board
ADC5: IC_MCU1.15 (ADCIN5/AC1BN1/PA09); also elsewhere on the board
ADC6: IC_MCU1.16 (ADCIN6/EIC-EXTINT[4]/PEVC-PAD_EVT[13]/P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); also elsewhere on the board
ADC7: IC_MCU1.17 (ADCIN7/ADCREF1/PEVC-PAD_EVT[14]/PA11); also elsewhere on the board
BOOTLOADER: IC_MCU1.100 (USB-VBOF/PEVC-PAD-EVT[7]/XOUT1/PB03); also elsewhere on the board
DMX0_RST: IC_MCU1.76 (PD02/SPI0-SCK/TC0-CLK2/EBI-DATA[15]/QDE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); also elsewhere on the board
DMX0_RX: IC_MCU1.56 (PC05/TWIMS1-TWCK/EIC-EXTINT[4]/USART2-R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), IC_MCU1.75 (PD01/SPI0-MISO/TC1-A0/EBI-DATA[14]/TC0-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); also elsewhere on the board
DMX0_RX_SENSE_RES: IC_MCU1.42 (MACB-CRS/TC0-A0/SPI1-MOSI/IISC-ISDO/PB19)
DMX0_TX: IC_MCU1.55 (PC04/TWIMS1-TWD/EIC-EXTINT[3]/USART2-TX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); also elsewhere on the board
DMX1_RST: IC_MCU1.77 (PD03/SPI0-NPCS[0]/TC0-B0/EBI-ADDR[0]/QD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); also elsewhere on the board
DMX1_RX: IC_MCU1.66 (PC18/PWM-PWML[0]/EIC-EXTINT[5]/EBI-SDA1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), IC_MCU1.99 (USB-ID/PEVC-PAD_EVT[6]/TC1-A1/XIN1/PB02); also elsewhere on the board
DMX1_RX_SENSE_RES: IC_MCU1.45 (MACB-RXD[3]/TC0-A1/SPI1-NPCS[3]/IISC-IS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)
DMX1_TX: IC_MCU1.65 (PC17/PWM-PWMH[0]/SPI0-NPCS[2]/EBI-RAS/I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); also elsewhere on the board
DMX2_RST: IC_MCU1.80 (PD09/USART1-DCD/CANIF-RXLINE[0]/EBI-ADD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); also elsewhere on the board
DMX2_RX: IC_MCU1.50 (PC01/USB-VBOF/SPI0-NPCS[2]/USART2-RTS/T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), IC_MCU1.79 (PD08/USART1-DSR/EIC-EXTINT[6]/EBI-ADDR[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); also elsewhere on the board
DMX2_TX: IC_MCU1.78 (PD07/USART1-DTR/EIC-EXTINT[5]/EBI-ADDR[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); also elsewhere on the board
DMXX_EN: IC_MCU1.81 (PD10/USART1-RI/CANIF-TXLINE[0]/EBI-ADDR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); also elsewhere on the board
FRONT_LED1: IC_MCU1.58 (PC07/PEVC_EVT[2]_/EBI_NCS[3]/USART2-RTS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); also elsewhere on the board
FRONT_LED2: IC_MCU1.57 (PC06/PEVC-PAD_EVT[15]/USART2-CLK/USART2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); also elsewhere on the board
FRONT_TASTER1: IC_MCU1.71 (PC23/QDEC1-QEPB/CANIF-RXLINE[1]/EBI-DAT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); also elsewhere on the board
FRONT_TASTER2: IC_MCU1.72 (PC24/QDEC1-QEPA/CANIF-TXLINE[1]/EBI-DAT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); also elsewhere on the board
FRONT_TASTER3: IC_MCU1.73 (PC31/SPI1-NPCS[3]/TC1-B0/EBI-DATA[12]/P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), TP_MCU7.TP
GND: C_M31.2, C_M32.2, C_M51.2, C_M52.2, C_MA1.2, C_MA2.2, C_MC1.2, C_MC2.2, C_MV1.2, C_MV2.2, C_MV3.2, C_Q3.2, C_Q4.2, IC_MCU1.6 (GNDIO), IC_MCU1.26 (GNDANA), IC_MCU1.37 (GNDPLL), IC_MCU1.41 (GNDCORE), IC_MCU1.54 (GNDIO), IC_MCU1.83 (GNDIO); also elsewhere on the board
J_TCK: IC_MCU1.1 (TCK/CANIF-TXLINE[1]/PA00); also elsewhere on the board
J_TDI: IC_MCU1.2 (TDI/CANIF-RXLINE[1]/PEVC-PAD_EVT[0]/PA01); also elsewhere on the board
J_TDO: IC_MCU1.3 (TDO/SCIF-GLK[0]/PEVC-PAD_EVT[1]/PA02); also elsewhere on the board
J_TMS: IC_MCU1.4 (TMS/SCIF-GCLK[1]/EIC-EXINT[1]/PA03); also elsewhere on the board
LED_1: IC_MCU1.9 (MACB-TX_ER/SPI1-SCK/QDEC1-QEPA/USART1-C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); also elsewhere on the board
LED_2: IC_MCU1.8 (MACB-TXD[3]/SPI1-MISO/CANIF-TXLINE[0]/P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); also elsewhere on the board
LED_3: IC_MCU1.7 (MACB-TXD[2]SPI1-MOSI/CANIF-RXLINE[0]/QD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); also elsewhere on the board
MACB_CLK: IC_MCU1.94 (PD29/USART0-CTS/EIC-EXTINT[6]/USART0-CL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); also elsewhere on the board
MACB_MDC: IC_MCU1.51 (PC02/TWIMS0-TWD/SPI0-NPCS[3]/USART2-RXD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); also elsewhere on the board
MACB_MDIO: IC_MCU1.52 (PC03/TWIMSO-TWCK/EIC-EXTINT[1]/USART2-T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); also elsewhere on the board
MACB_PWRDN: IC_MCU1.89 (PD22/USART3-RXD/TC0-A2]/EBI-ADDR[18]/SC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); also elsewhere on the board
MACB_RST: IC_MCU1.97 (CANIF-TXLINE[1]/PEVC-PAD_EVT[11]/XOUT32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); also elsewhere on the board
MACB_RXD0: IC_MCU1.86 (PD13/USART1-CTS/USART1-CLK/EBI-SDCK/PEV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); also elsewhere on the board
MACB_RXD1: IC_MCU1.87 (PD14/USART1-RTS/EIC-EXTINT[7]/EBI-ADDR[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); also elsewhere on the board
MACB_RX_DV: IC_MCU1.93 (PD28/USART0-RXD/CANIF-TXLINE[0]/EBI-NCS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); also elsewhere on the board
MACB_RX_ER: IC_MCU1.92 (PD27/USART0-TXD/CANIF-RXLINE[0]/EBI-NCS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); also elsewhere on the board
MACB_TXD0: IC_MCU1.84 (PD11/USART1-TXD/USB-ID/EBI-ADDR[8]/PEVC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); also elsewhere on the board
MACB_TXD1: IC_MCU1.85 (PD12/USART1-RXD/USB-VBOF/EBI-ADDR[9]/PE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); also elsewhere on the board
MACB_TX_EN: IC_MCU1.95 (PD30/USART0-RXD/EIC-EXTINT[3]/EBI-NWAIT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); also elsewhere on the board
unnamed: C_MC1.1, C_MC2.1, IC_MCU1.40 (VDDCORE)
unnamed: C_Q3.1, IC_MCU1.47 (XIN0/PB30), Q1.2
unnamed: IC_MCU1.28 (ADCIN9/AC0AP0/DAC0A/PA20), TP_MCU1.TP
unnamed: C_Q4.1, IC_MCU1.48 (XOUT0/PB31), Q1.1
unnamed: IC_MCU1.29 (ADCIN10/AC0BN0/DAC0B/PA21), TP_MCU2.TP
unnamed: IC_MCU1.30 (MACB-SPEED/ADCIN11/AC0AN0/PEVC-PAD_EVT[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), TP_MCU3.TP
unnamed: C_AC1.1, IC_MCU1.23 (ADCREFP/PA17)
unnamed: C_AC1.2, IC_MCU1.24 (ADCREFN/PA18)
unnamed: IC_MCU1.31 (MACB-WOL/ADCIN12/AC0BP0/PEVC-PAD_EVT[5]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), TP_MCU4.TP
unnamed: IC_MCU1.32 (ADCIN13/SPI1-NCS[2]/PA24), TP_MCU5.TP
unnamed: IC_MCU1.33 (ADCIN14/SPI1-NPCS[3]/EIC-EXTINT[0]/PA25), TP_MCU6.TP
RASP_BUSY: IC_MCU1.61 (PC13/PWM-PWMH[2]/EIC-EXTINT[7]/EBI-SDCS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); also elsewhere on the board
RASP_OFF: IC_MCU1.62 (PC14/PWM-PWML[2]/USART0-CLK/EBI-SDCKE/U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); also elsewhere on the board
RASP_RELAY: IC_MCU1.59 (PC11/PWM-PWMH[3]/CANIF-RXLINE[1]/EBI-AD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); also elsewhere on the board
RASP_RX: IC_MCU1.63 (PC15/PWM-PWMH[1]/SPI0-NPCS[0]/EBI-SDWE/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); also elsewhere on the board
RASP_TX: IC_MCU1.64 (PC16/PWM-PWML[1]/SPI0-NPCS[1]/EBI-CAS/U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); also elsewhere on the board
RESET: IC_MCU1.98 (!RESET); also elsewhere on the board
USB_DM: IC_MCU1.35 (DM); also elsewhere on the board
USB_DP: IC_MCU1.36 (DP); also elsewhere on the board
USB_VBUS: IC_MCU1.34 (VBUS); also elsewhere on the board

Notes on the sheet:
Controller
Peter Weissig
JTAG & aWire
ADC
Ethernet
DMX
Rasp
DMX-Sense
Leds
Bootloader
Test-Pads
Front

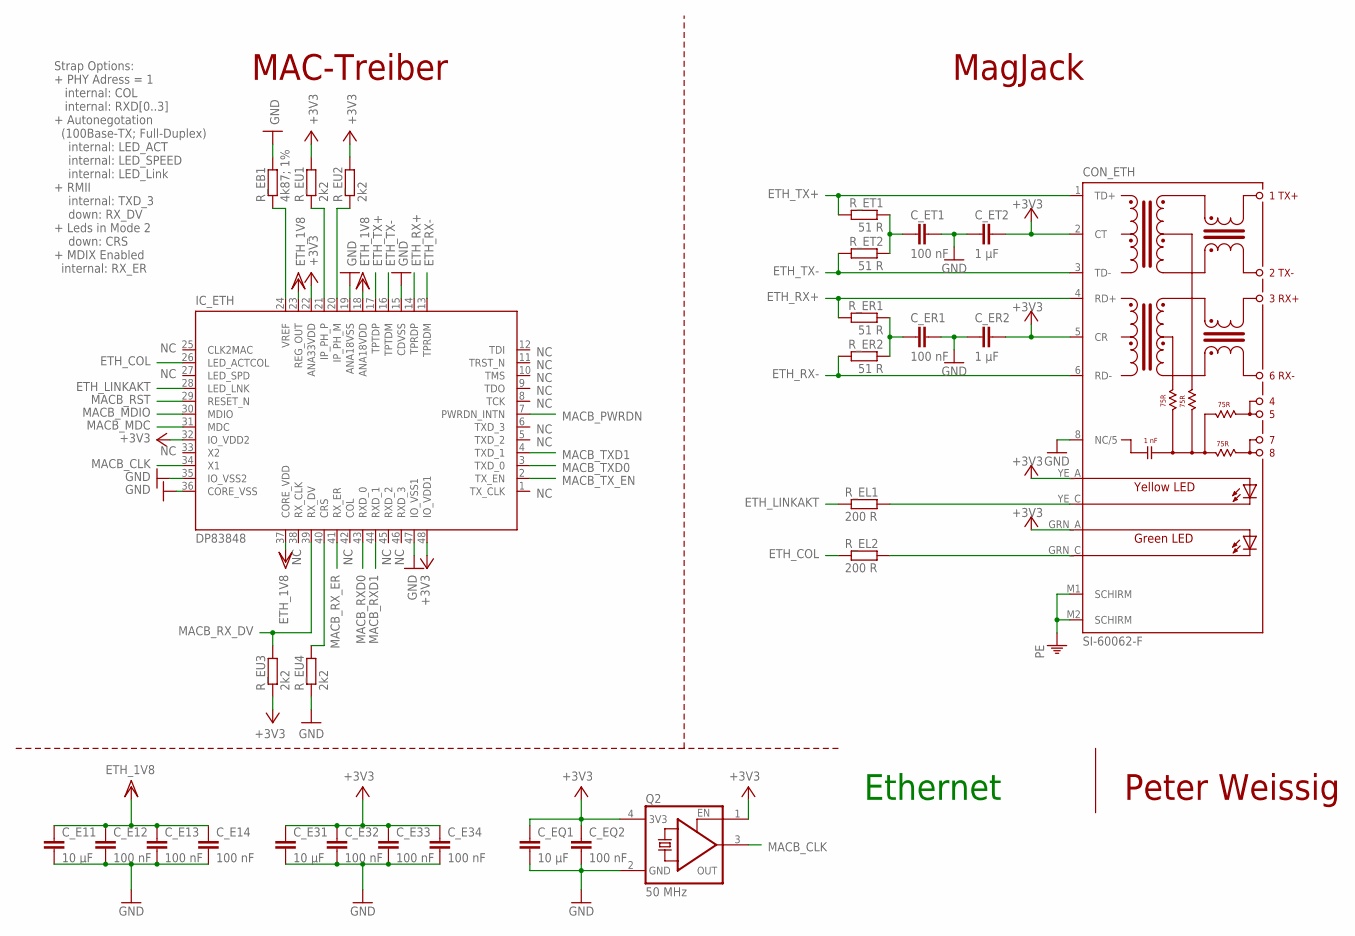
[picture p21: schematic circuit.sch, sheet 2, Ethernet]

Parts:
CON_ETH: SI-60062-F; MAG_JACK
C_E11, C_E31: 10 µF; C0603
C_E12, C_E13, C_E14, C_E32, C_E33, C_E34: 100 nF; C0603
C_EQ1: 10 µF; C0603
C_EQ2: 100 nF; C0603
C_ER1: 100 nF; C0603
C_ER2: 1 µF; C0603
C_ET1: 100 nF; C0603
C_ET2: 1 µF; C0603
IC_ETH: DP83848; LQFP48
Q2: 50 MHz; XO53
R_EB1: 4k87; 1%; R0603
R_EL1, R_EL2: 200 R; R0603
R_ER1, R_ER2: 51 R; R0603
R_ET1, R_ET2: 51 R; R0603
R_EU1, R_EU2, R_EU3, R_EU4: 2k2; R0603

Connections:
+3V3: CON_ETH.2 (CT), CON_ETH.5 (CR), CON_ETH.GRN_A (AL), CON_ETH.YE_A (A-R), C_E31.1, C_E32.1, C_E33.1, C_E34.1, C_EQ1.1, C_EQ2.1, C_ER2.2, C_ET2.2, IC_ETH.22 (ANA33VDD), IC_ETH.32 (IO_VDD2), IC_ETH.48 (IO_VDD1), Q2.1 (EN), Q2.4 (3V3), R_EU1.2, R_EU2.2, R_EU3.1; also elsewhere on the board
ETH_1V8: C_E11.1, C_E12.1, C_E13.1, C_E14.1, IC_ETH.18 (ANA18VDD), IC_ETH.23 (REG_OUT), IC_ETH.37 (CORE_VDD)
ETH_COL: IC_ETH.26 (LED_ACTCOL), R_EL2.1
ETH_LINKAKT: IC_ETH.28 (LED_LNK), R_EL1.1
ETH_RX+: CON_ETH.4 (RD+), IC_ETH.14 (TPRDP), R_ER1.2
ETH_RX-: CON_ETH.6 (RD-), IC_ETH.13 (TPRDM), R_ER2.2
ETH_TX+: CON_ETH.1 (TD+), IC_ETH.17 (TPTDP), R_ET1.2
ETH_TX-: CON_ETH.3 (TD-), IC_ETH.16 (TPTDM), R_ET2.2
GND: CON_ETH.8 (NC/5), C_E11.2, C_E12.2, C_E13.2, C_E14.2, C_E31.2, C_E32.2, C_E33.2, C_E34.2, C_EQ1.2, C_EQ2.2, C_ER1.2, C_ER2.1, C_ET1.2, C_ET2.1, IC_ETH.15 (CDVSS), IC_ETH.19 (ANA18VSS), IC_ETH.35 (IO_VSS2), IC_ETH.36 (CORE_VSS), IC_ETH.47 (IO_VSS1), Q2.2 (GND), R_EB1.2, R_EU4.1; also elsewhere on the board
MACB_CLK: IC_ETH.34 (X1), Q2.3 (OUT); also elsewhere on the board
MACB_MDC: IC_ETH.31 (MDC); also elsewhere on the board
MACB_MDIO: IC_ETH.30 (MDIO); also elsewhere on the board
MACB_PWRDN: IC_ETH.7 (PWRDN_INTN); also elsewhere on the board
MACB_RST: IC_ETH.29 (RESET_N); also elsewhere on the board
MACB_RXD0: IC_ETH.43 (RXD_0); also elsewhere on the board
MACB_RXD1: IC_ETH.44 (RXD_1); also elsewhere on the board
MACB_RX_DV: IC_ETH.39 (RX_DV), R_EU3.2; also elsewhere on the board
MACB_RX_ER: IC_ETH.41 (RX_ER); also elsewhere on the board
MACB_TXD0: IC_ETH.3 (TXD_0); also elsewhere on the board
MACB_TXD1: IC_ETH.4 (TXD_1); also elsewhere on the board
MACB_TX_EN: IC_ETH.2 (TX_EN); also elsewhere on the board
unnamed: IC_ETH.24 (VREF), R_EB1.1
unnamed: IC_ETH.21 (IP_PH_P), R_EU1.1
unnamed: IC_ETH.20 (IP_PH_M), R_EU2.1
unnamed: IC_ETH.40 (CRS), R_EU4.2
unnamed: CON_ETH.YE_C (C-R), R_EL1.2
unnamed: CON_ETH.GRN_C (C-L), R_EL2.2
unnamed: C_ER1.1, R_ER1.1, R_ER2.1
unnamed: C_ET1.1, R_ET1.1, R_ET2.1
PE: CON_ETH.M1 (SCHIRM), CON_ETH.M2 (SCHIRM); also elsewhere on the board

Notes on the sheet:
Ethernet
Peter Weissig
MagJack
MAC-Treiber
ETH_1V8
Strap Options: + PHY Adress = 1 internal: COL internal: RXD[0..3] + Autonegotation (100Base-TX; Full-Duplex) internal: LED_ACT internal: LED_SPEED internal: LED_Link + RMII internal: TXD_3 down: RX_DV + Leds in Mode 2 down: CRS + MDIX Enabled internal: RX_ER

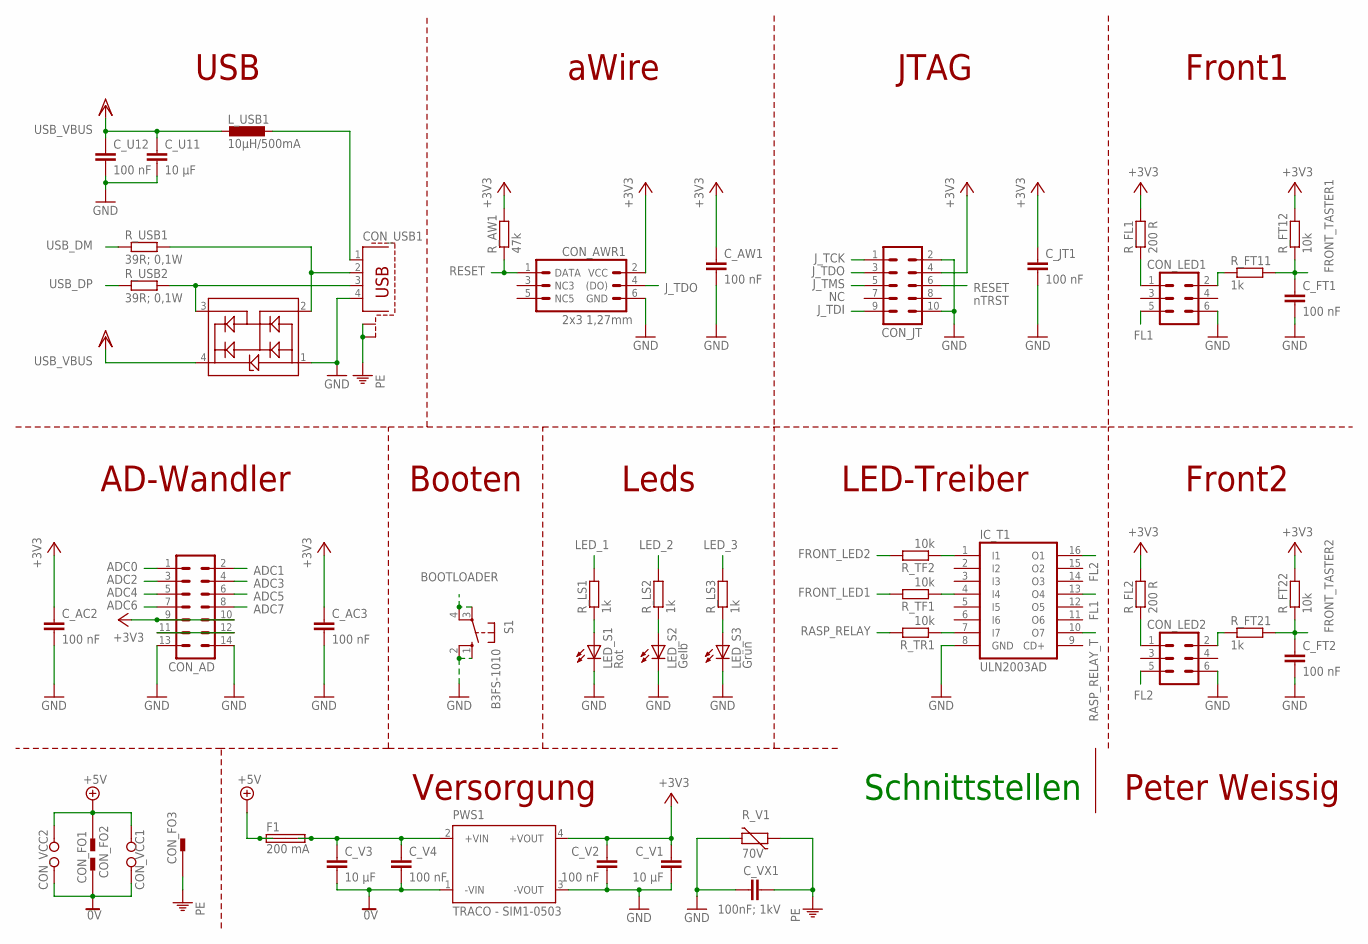
[picture p22: schematic circuit.sch, sheet 3, Schnittstellen]

Parts:
CON_AD: ML14
CON_AWR1: 2x3 1,27mm; 2X3_MINI
CON_FO1, CON_FO2, CON_FO3: PIN2F061.100; F061.100
CON_JT: ML10
CON_LED1, CON_LED2: ML6
CON_USB1: PN61729-S
CON_VCC1, CON_VCC2: W237-02P; W237-132
C_AC2, C_AC3: 100 nF; C0603K
C_AW1: 100 nF; C0603K
C_FT1, C_FT2: 100 nF; C0603K
C_JT1: 100 nF; C0603K
C_U11: 10 µF; C0805K
C_U12: 100 nF; C0603K
C_V1, C_V3: 10 µF; C0603K
C_V2, C_V4: 100 nF; C0603K
C_VX1: 100nF; 1kV; C1812K
D1: PRTR5V0U2X; SOT143-R
F1: 200 mA; SHK20L
IC_T1: ULN2003AD; SO16
LED_S1: Rot; CHIPLED_1206
LED_S2: Gelb; CHIPLED_1206
LED_S3: Grün; CHIPLED_1206
L_USB1: 10µH/500mA; L1210
PWS1: TRACO - SIM1-0503; TRACO_TME_1
R_AW1: 47k; R0603
R_FL1, R_FL2: 200 R; R0603
R_FT11, R_FT21: 1k; R0603
R_FT12, R_FT22: 10k; R0603
R_LS1, R_LS2, R_LS3: 1k; R0603
R_TF1, R_TF2: 10k; R0603
R_TR1: 10k; R0603
R_USB1, R_USB2: 39R; 0,1W; R0603
R_V1: 70V; CT/CN1206
S1: B3FS-1010; B3F-10XX

Connections:
0V: CON_FO1.A1, CON_FO1.A2, CON_VCC1.2, CON_VCC2.2, C_V3.2, C_V4.2, PWS1.1 (-VIN); also elsewhere on the board
+3V3: CON_AD.9, CON_AD.10, CON_AWR1.2 (VCC), CON_JT.4, C_AC2.1, C_AC3.1, C_AW1.1, C_JT1.1, C_V1.1, C_V2.1, PWS1.4 (+VOUT), R_AW1.2, R_FL1.2, R_FL2.2, R_FT12.2, R_FT22.2; also elsewhere on the board
+5V: CON_FO2.A1, CON_FO2.A2, CON_VCC1.1, CON_VCC2.1, F1.1A, F1.1B; also elsewhere on the board
ADC0: CON_AD.1; also elsewhere on the board
ADC1: CON_AD.2; also elsewhere on the board
ADC2: CON_AD.3; also elsewhere on the board
ADC3: CON_AD.4; also elsewhere on the board
ADC4: CON_AD.5; also elsewhere on the board
ADC5: CON_AD.6; also elsewhere on the board
ADC6: CON_AD.7; also elsewhere on the board
ADC7: CON_AD.8; also elsewhere on the board
BOOTLOADER: S1.3, S1.4 (P1); also elsewhere on the board
FL1: CON_LED1.5, IC_T1.13 (O4)
FL2: CON_LED2.5, IC_T1.16 (O1)
FRONT_LED1: R_TF1.2; also elsewhere on the board
FRONT_LED2: R_TF2.2; also elsewhere on the board
FRONT_TASTER1: C_FT1.1, R_FT11.2, R_FT12.1; also elsewhere on the board
FRONT_TASTER2: C_FT2.1, R_FT21.2, R_FT22.1; also elsewhere on the board
GND: CON_AD.13, CON_AD.14, CON_AWR1.6 (GND), CON_JT.2, CON_JT.10, CON_LED1.6, CON_LED2.6, CON_USB1.4, C_AC2.2, C_AC3.2, C_AW1.2, C_FT1.2, C_FT2.2, C_JT1.2, C_U11.2, C_U12.2, C_V1.2, C_V2.2, C_VX1.1, D1.1 (GND), IC_T1.8 (GND), LED_S1.C, LED_S2.C, LED_S3.C, PWS1.3 (-VOUT), R_V1.2, S1.1 (S), S1.2 (S1); also elsewhere on the board
J_TCK: CON_JT.1; also elsewhere on the board
J_TDI: CON_JT.9; also elsewhere on the board
J_TDO: CON_AWR1.4 ((DO)), CON_JT.3; also elsewhere on the board
J_TMS: CON_JT.5; also elsewhere on the board
LED_1: R_LS1.2; also elsewhere on the board
LED_2: R_LS2.2; also elsewhere on the board
LED_3: R_LS3.2; also elsewhere on the board
unnamed: LED_S1.A, R_LS1.1
unnamed: LED_S2.A, R_LS2.1
unnamed: CON_USB1.3, D1.3 (IN/OUT2), R_USB2.2
unnamed: CON_USB1.2, D1.2 (IN/OUT1), R_USB1.2
unnamed: LED_S3.A, R_LS3.1
unnamed: CON_USB1.1, L_USB1.1
unnamed: CON_AD.11, CON_AD.12
unnamed: IC_T1.4 (I4), R_TF1.1
unnamed: CON_LED1.1, R_FL1.1
unnamed: C_V3.1, C_V4.1, F1.2A, F1.2B, PWS1.2 (+VIN)
unnamed: CON_LED1.2, R_FT11.1
unnamed: CON_LED2.1, R_FL2.1
unnamed: CON_LED2.2, R_FT21.1
unnamed: IC_T1.1 (I1), R_TF2.1
unnamed: IC_T1.7 (I7), R_TR1.1
PE: CON_FO3.A1, CON_FO3.A2, CON_USB1.S1, CON_USB1.S2, C_VX1.2, R_V1.1; also elsewhere on the board
RASP_RELAY: R_TR1.2; also elsewhere on the board
RASP_RELAY_T: IC_T1.10 (O7); also elsewhere on the board
RESET: CON_AWR1.1 (DATA), CON_JT.6, R_AW1.1; also elsewhere on the board
USB_DM: R_USB1.1; also elsewhere on the board
USB_DP: R_USB2.1; also elsewhere on the board
USB_VBUS: C_U11.1, C_U12.1, D1.4 (VDD), L_USB1.2; also elsewhere on the board

Notes on the sheet:
Schnittstellen
USB
Leds
aWire
Booten
Peter Weissig
AD-Wandler
Versorgung
JTAG
nTRST
CON_VCC2
CON_VCC1
LED-Treiber
Front2
Front1

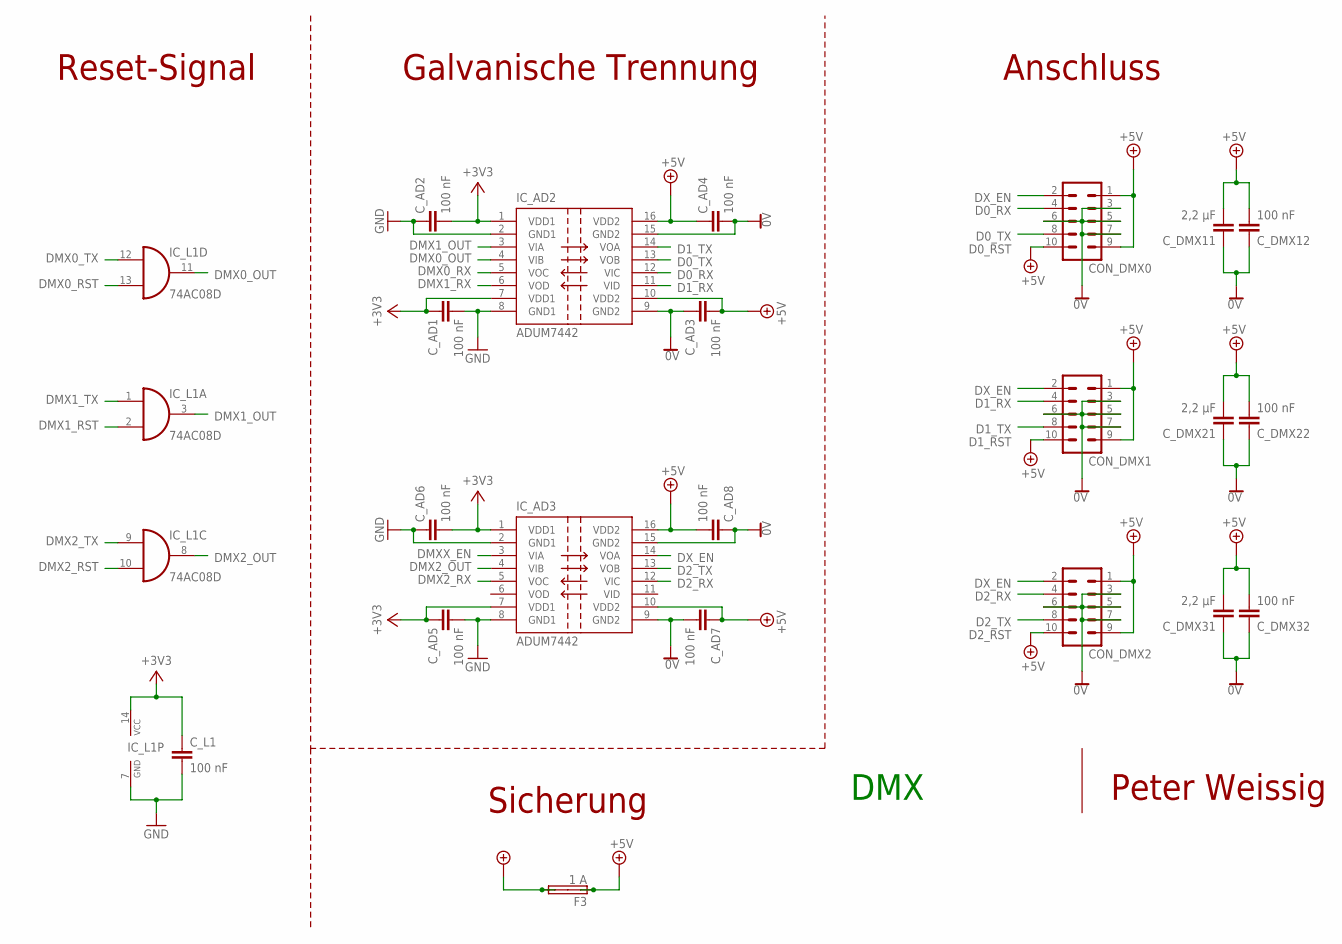
[picture p23: schematic circuit.sch, sheet 4, DMX]

Parts:
CON_DMX0, CON_DMX1, CON_DMX2: ML10
C_AD1, C_AD2, C_AD3, C_AD4, C_AD5, C_AD6, C_AD7, C_AD8: 100 nF; C0603K
C_DMX11, C_DMX21, C_DMX31: 2,2 µF; C0603K
C_DMX12, C_DMX22, C_DMX32: 100 nF; C0603K
C_L1: 100 nF; C0603K
F3: 1 A; SHK20L
IC_AD2, IC_AD3: ADUM7442; SOP64P600X175-16N
IC_L1: 74AC08D; SO14

Connections:
0V: CON_DMX0.3, CON_DMX0.5, CON_DMX0.6, CON_DMX0.7, CON_DMX1.3, CON_DMX1.5, CON_DMX1.6, CON_DMX1.7, CON_DMX2.3, CON_DMX2.5, CON_DMX2.6, CON_DMX2.7, C_AD3.1, C_AD4.2, C_AD7.2, C_AD8.1, C_DMX11.1, C_DMX12.1, C_DMX21.1, C_DMX22.1, C_DMX31.1, C_DMX32.1, IC_AD2.9 (GND2), IC_AD2.15 (GND2), IC_AD3.9 (GND2), IC_AD3.15 (GND2); also elsewhere on the board
+3V3: C_AD1.1, C_AD2.2, C_AD5.1, C_AD6.2, C_L1.1, IC_AD2.1 (VDD1), IC_AD2.7 (VDD1), IC_AD3.1 (VDD1), IC_AD3.7 (VDD1), IC_L1.14 (VCC); also elsewhere on the board
+5V: F3.2A, F3.2B; also elsewhere on the board
D0_RX: CON_DMX0.4, IC_AD2.12 (VIC)
D0_TX: CON_DMX0.8, IC_AD2.13 (VOB)
D1_RX: CON_DMX1.4, IC_AD2.11 (VID)
D1_TX: CON_DMX1.8, IC_AD2.14 (VOA)
D2_RX: CON_DMX2.4, IC_AD3.12 (VIC)
D2_TX: CON_DMX2.8, IC_AD3.13 (VOB)
DMX0_OUT: IC_AD2.4 (VIB), IC_L1.11 (O)
DMX0_RST: IC_L1.13 (I1); also elsewhere on the board
DMX0_RX: IC_AD2.5 (VOC); also elsewhere on the board
DMX0_TX: IC_L1.12 (I0); also elsewhere on the board
DMX1_OUT: IC_AD2.3 (VIA), IC_L1.3 (O)
DMX1_RST: IC_L1.2 (I1); also elsewhere on the board
DMX1_RX: IC_AD2.6 (VOD); also elsewhere on the board
DMX1_TX: IC_L1.1 (I0); also elsewhere on the board
DMX2_OUT: IC_AD3.4 (VIB), IC_L1.8 (O)
DMX2_RST: IC_L1.10 (I1); also elsewhere on the board
DMX2_RX: IC_AD3.5 (VOC); also elsewhere on the board
DMX2_TX: IC_L1.9 (I0); also elsewhere on the board
DMXX_EN: IC_AD3.3 (VIA); also elsewhere on the board
DV_5V: CON_DMX0.1, CON_DMX0.9, CON_DMX0.10, CON_DMX1.1, CON_DMX1.9, CON_DMX1.10, CON_DMX2.1, CON_DMX2.9, CON_DMX2.10, C_AD3.2, C_AD4.1, C_AD7.1, C_AD8.2, C_DMX11.2, C_DMX12.2, C_DMX21.2, C_DMX22.2, C_DMX31.2, C_DMX32.2, F3.1A, F3.1B, IC_AD2.10 (VDD2), IC_AD2.16 (VDD2), IC_AD3.10 (VDD2), IC_AD3.16 (VDD2)
DX_EN: CON_DMX0.2, CON_DMX1.2, CON_DMX2.2, IC_AD3.14 (VOA)
GND: C_AD1.2, C_AD2.1, C_AD5.2, C_AD6.1, C_L1.2, IC_AD2.2 (GND1), IC_AD2.8 (GND1), IC_AD3.2 (GND1), IC_AD3.8 (GND1), IC_L1.7 (GND); also elsewhere on the board

Notes on the sheet:
DMX
Peter Weissig
Galvanische Trennung
D0_RST
D1_RST
D2_RST
Anschluss
Reset-Signal
Sicherung

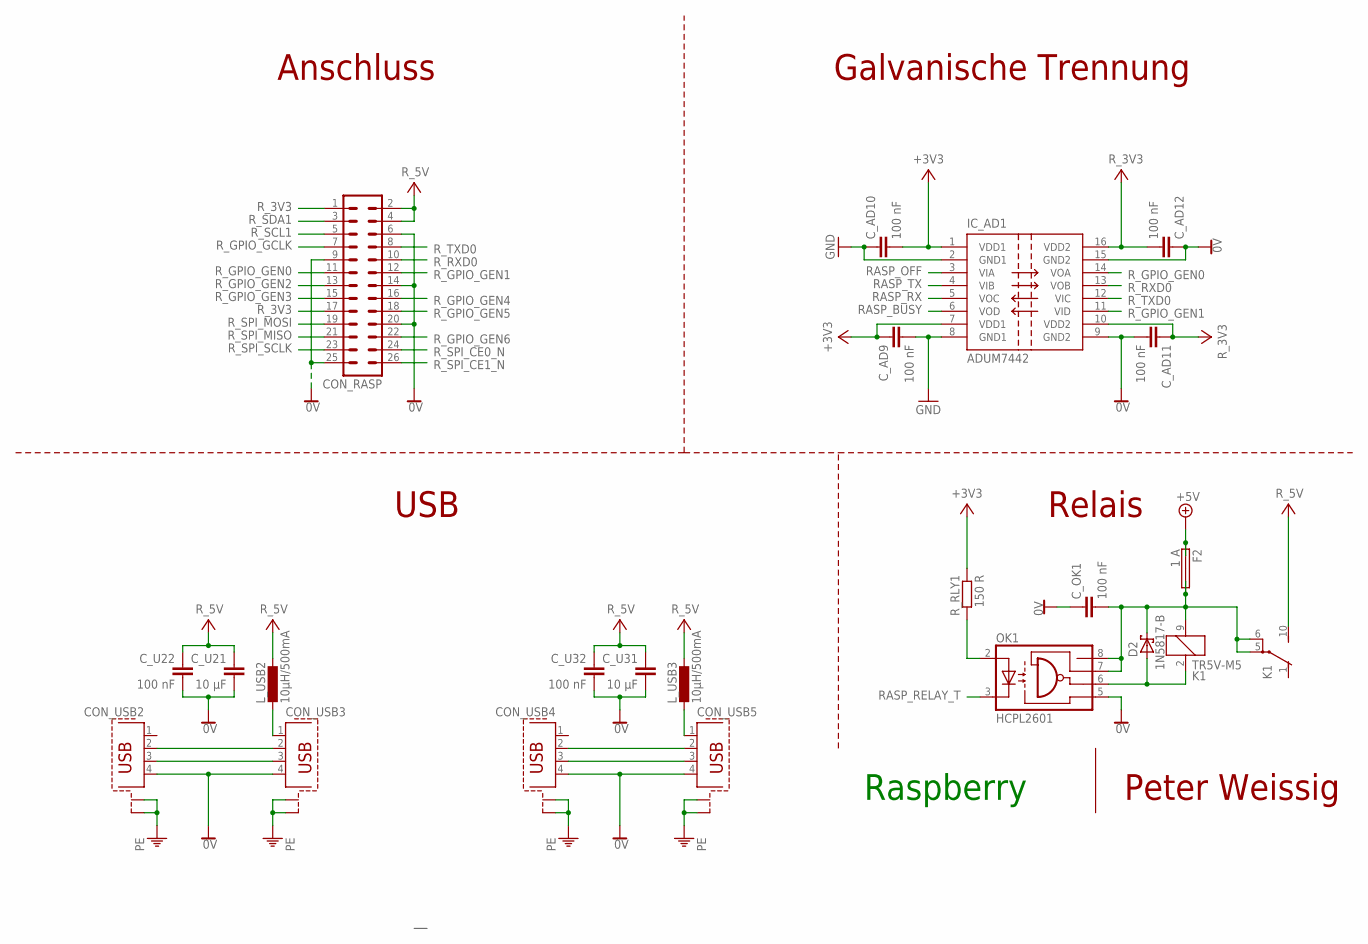
[picture p24: schematic circuit.sch, sheet 5, Raspberry]

Parts:
CON_RASP: ML26
CON_USB2, CON_USB4: PN61729-S
CON_USB3, CON_USB5: PN87520-S
C_AD9, C_AD10, C_AD11, C_AD12: 100 nF; C0603K
C_OK1: 100 nF; C0603K
C_U21, C_U31: 10 µF; C0805K
C_U22, C_U32: 100 nF; C0603K
D2: 1N5817-B; DO41-7.6
F2: 1 A; SHK20L
IC_AD1: ADUM7442; SOP64P600X175-16N
K1: TR5V-M5; G5V1
L_USB2, L_USB3: 10µH/500mA; L1210
OK1: HCPL2601; DIL08
R_RLY1: 150 R; R0603

Connections:
0V: CON_RASP.6, CON_RASP.9, CON_RASP.14, CON_RASP.20, CON_RASP.25, CON_USB2.4, CON_USB3.4, CON_USB4.4, CON_USB5.4, C_AD11.2, C_AD12.1, C_OK1.1, C_U21.2, C_U22.2, C_U31.2, C_U32.2, IC_AD1.9 (GND2), IC_AD1.15 (GND2), OK1.5 (GND); also elsewhere on the board
+3V3: C_AD9.1, C_AD10.2, IC_AD1.1 (VDD1), IC_AD1.7 (VDD1), R_RLY1.1; also elsewhere on the board
+5V: F2.1A, F2.1B; also elsewhere on the board
GND: C_AD9.2, C_AD10.1, IC_AD1.2 (GND1), IC_AD1.8 (GND1); also elsewhere on the board
unnamed: D2.A, K1.2 (1), OK1.6 (OUT)
unnamed: CON_USB4.2, CON_USB5.2
unnamed: CON_USB2.2, CON_USB3.2
unnamed: CON_USB2.3, CON_USB3.3
unnamed: CON_USB4.3, CON_USB5.3
unnamed: OK1.2 (A), R_RLY1.2
unnamed: CON_USB5.1, L_USB3.2
unnamed: CON_USB3.1, L_USB2.2
unnamed: C_OK1.2, D2.C, F2.2A, F2.2B, K1.5, K1.6, K1.9 (2), OK1.7 (EN), OK1.8 (VCC)
PE: CON_USB2.S1, CON_USB2.S2, CON_USB3.S1, CON_USB3.S2, CON_USB4.S1, CON_USB4.S2, CON_USB5.S1, CON_USB5.S2; also elsewhere on the board
RASP_BUSY: IC_AD1.6 (VOD); also elsewhere on the board
RASP_OFF: IC_AD1.3 (VIA); also elsewhere on the board
RASP_RELAY_T: OK1.3 (C); also elsewhere on the board
RASP_RX: IC_AD1.5 (VOC); also elsewhere on the board
RASP_TX: IC_AD1.4 (VIB); also elsewhere on the board
R_3V3: CON_RASP.1, CON_RASP.17, C_AD11.1, C_AD12.2, IC_AD1.10 (VDD2), IC_AD1.16 (VDD2)
R_5V: CON_RASP.2, CON_RASP.4, C_U21.1, C_U22.1, C_U31.1, C_U32.1, K1.10 (S), L_USB2.1, L_USB3.1
R_GPIO_GCLK: CON_RASP.7
R_GPIO_GEN0: CON_RASP.11, IC_AD1.14 (VOA)
R_GPIO_GEN1: CON_RASP.12, IC_AD1.11 (VID)
R_GPIO_GEN2: CON_RASP.13
R_GPIO_GEN3: CON_RASP.15
R_GPIO_GEN4: CON_RASP.16
R_GPIO_GEN5: CON_RASP.18
R_GPIO_GEN6: CON_RASP.22
R_RXD0: CON_RASP.10, IC_AD1.13 (VOB)
R_SCL1: CON_RASP.5
R_SDA1: CON_RASP.3
R_SPI_CE0_N: CON_RASP.24
R_SPI_CE1_N: CON_RASP.26
R_SPI_MISO: CON_RASP.21
R_SPI_MOSI: CON_RASP.19
R_SPI_SCLK: CON_RASP.23
R_TXD0: CON_RASP.8, IC_AD1.12 (VIC)

Notes on the sheet:
Raspberry
Peter Weissig
Anschluss
Galvanische Trennung
Relais
USB

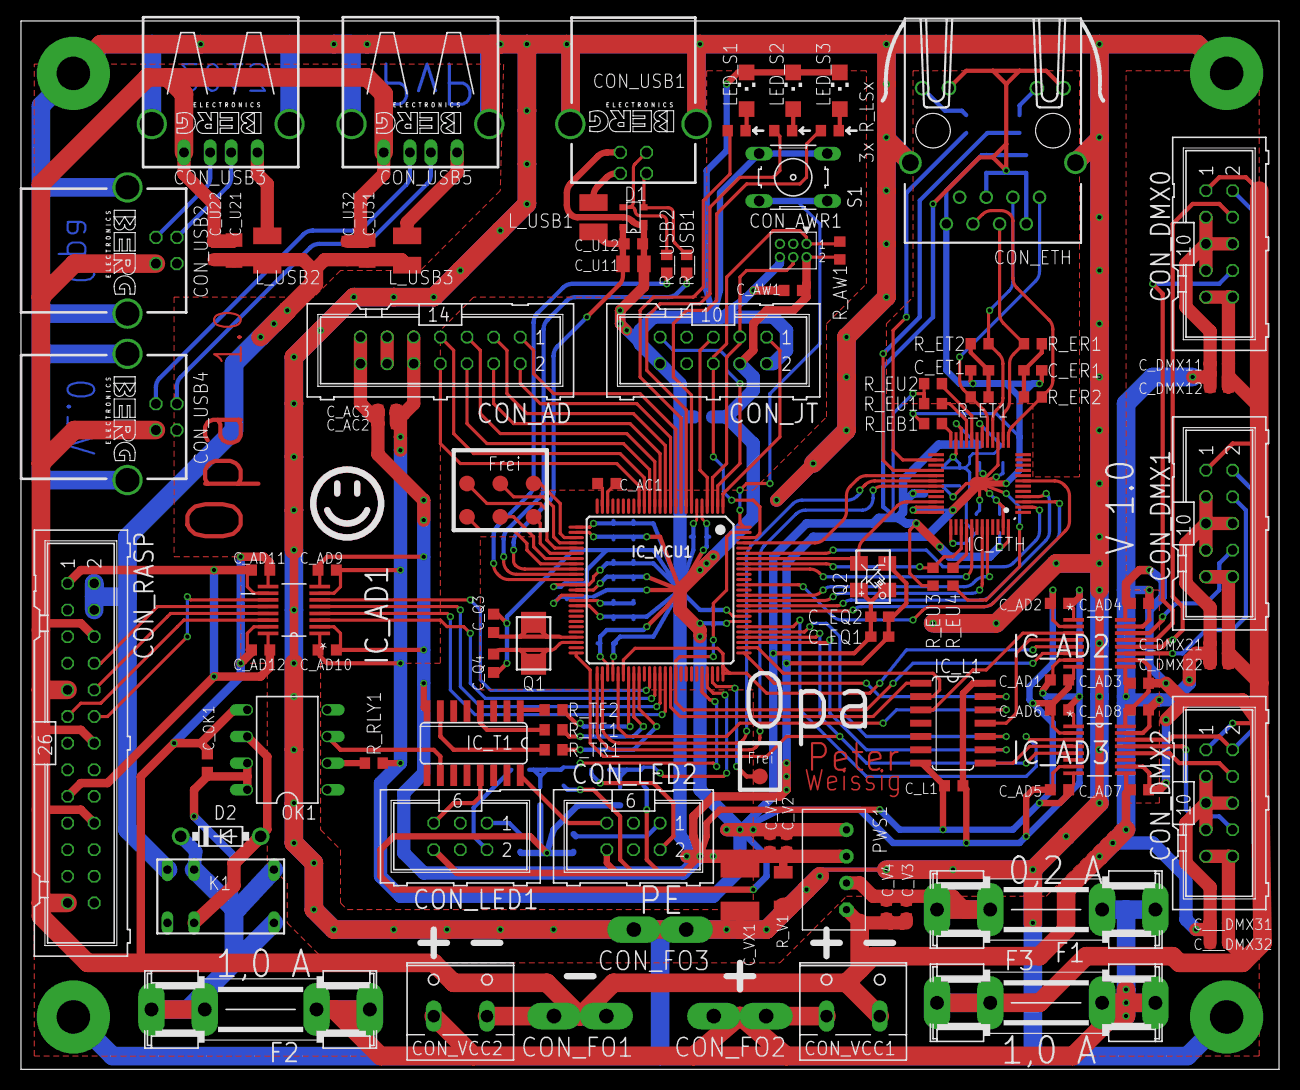
[picture p25: board circuit.brd from above]

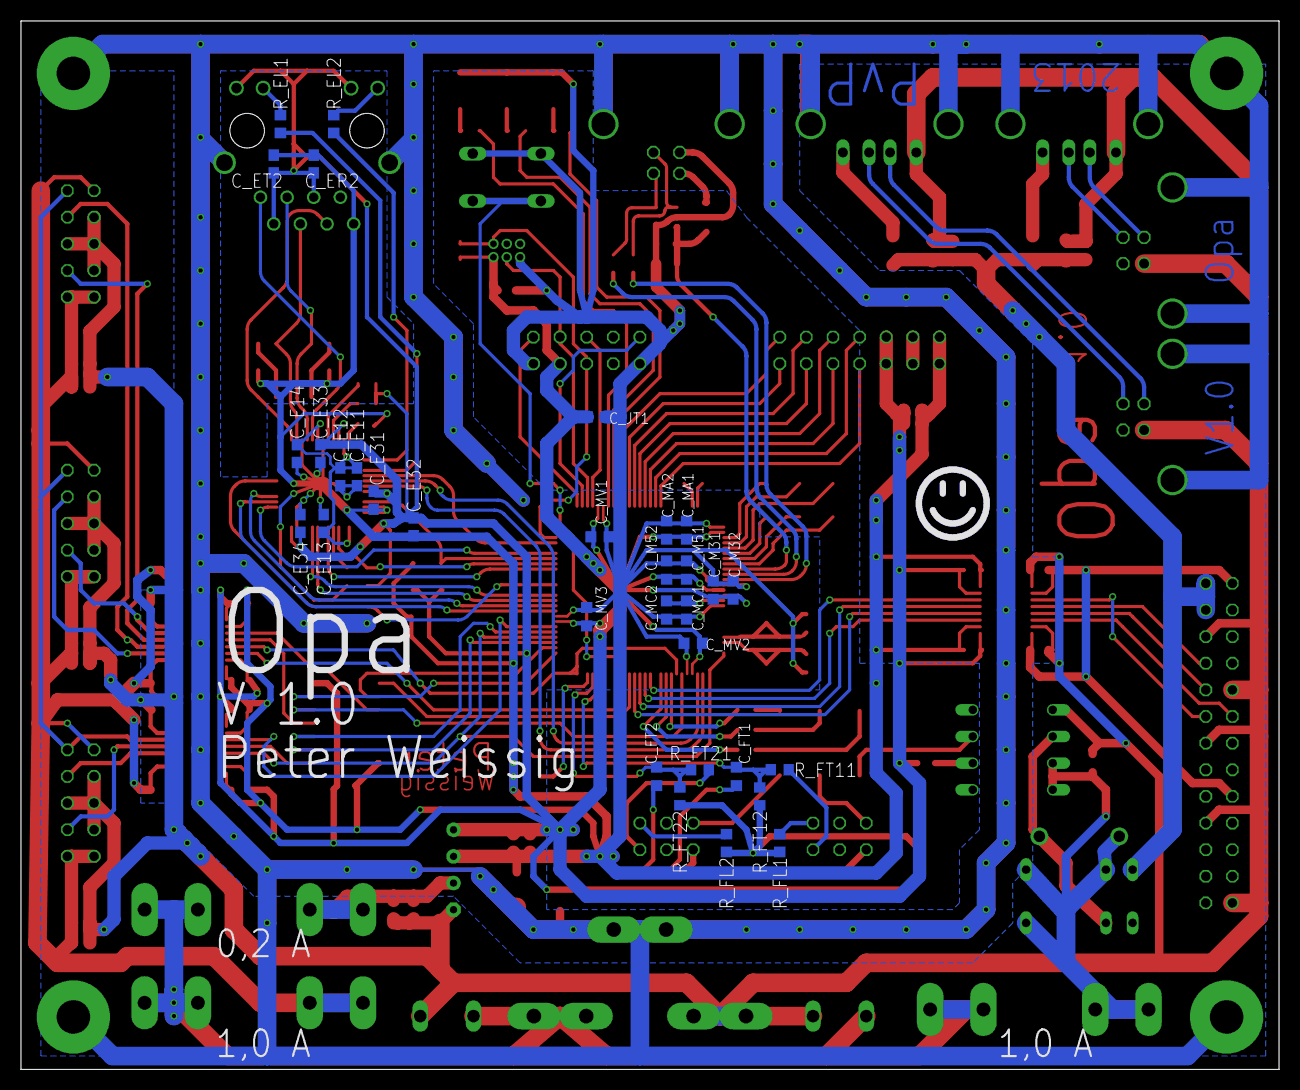
[picture p26: board circuit.brd from below]

Board: 2 copper layers, 120.0 x 100.0 mm, 144 parts (32 on the bottom side), 127 nets.
